ProtiumPower/Pantograph-Robot/python/tests/protocol1_0/My/camera_view.jpg

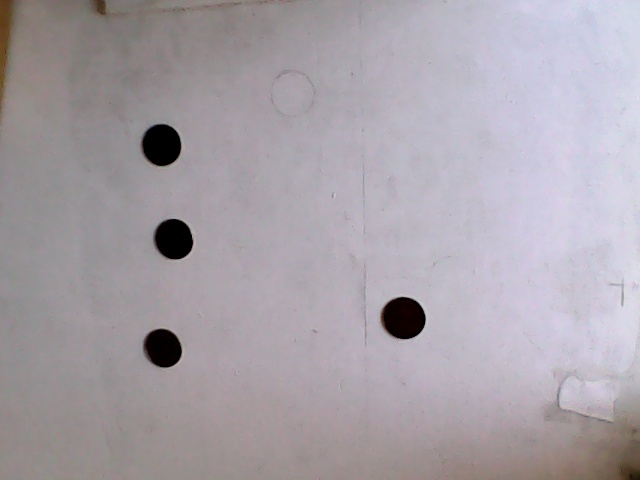
python/tests/protocol1_0/My/camera_view.jpg
