ProtiumPower/Pantograph-Robot/python/tests/protocol1_0/My/rotated.jpg

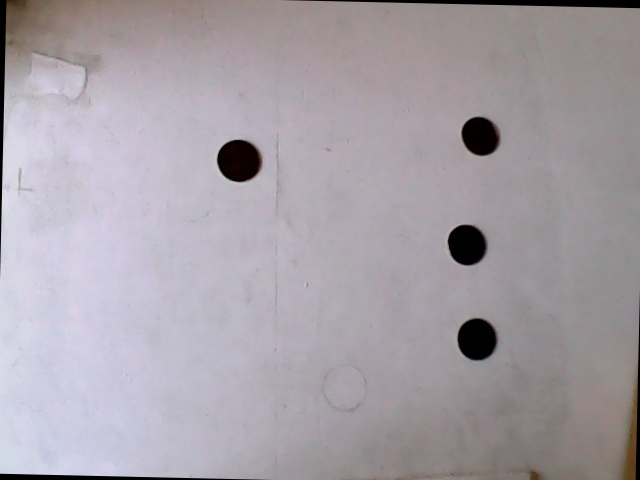
python/tests/protocol1_0/My/rotated.jpg
