ProtiumPower/Pantograph-Robot/Thesis.pdf

# Design and Development of 5 link 2-D Pantograph Parallel Robot

BY

## Ninad Reshim Nakade

(Admission No. 19JE0574)

## Abhishek Aman

(Admission No. 19JE0024)

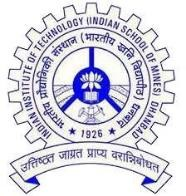
[picture p3: figure]

THESIS SUBMITTED TO

### DEPARTMENT OF MECHANICAL ENGINEERING INDIAN INSTITUTE OF TECHNOLOGY (ISM), DHANBAD – 826004

### 16 May 2023

For the award of the degree of BACHELOR OF TECHNOLOGY

### Supervisor: Prof. Arun Udai

ii

iii

## CERTIFICATE

This is to certify that the thesis titled “Design and Development of 5 link 2-D Pantograph Parallel Robot” being submitted by Mr. Ninad Reshim Nakade (Admission no: 19JE0574) and Mr. Abhishek Aman (Admission no: 19JE0024) for
the award of the degree of Bachelor of Technology in the Department of Mechanical Engineering of Indian Institute of Technology (Indian School of Mines), Dhanbad is a record of bonafide research work carried out by him/her under my supervision. In my opinion, the thesis is worthy of consideration for the award of the degree of Bachelor of Technology in accordance with the regulations of the institute. The results presented in the thesis have not been submitted to any other university or institute for the award of any degree.

Prof. Arun Udai
Assistant Professor
Department of Mechanical Engineering,
Indian Institute of Technology (ISM) Dhanbad-826004, Jharkhand, INDIA

Date: 16-May-2023

iv

## DECLARATION

I hereby declare that the work which is being presented in this dissertation entitled “Design and Development of 5 link 2-D Pantograph Parallel Robot” in partial fulfillment of the requirements for the award of the degree of B.Tech in is an authentic record of my own work carried out during the period from June 2022 to May 2023 under the supervision of Prof. Arun Udai Department of Mechanical Engineering, Indian Institute of Technology (ISM) Dhanbad, Jharkhand, India.
I acknowledge that I have read and understood the UGC (Promotion of Academic Integrity and Prevention of Plagiarism in Higher Educational Institutions) Regulations, 2018. These Regulations were published in the Indian Official Gazette on 31st July, 2018.
I confirm that this Dissertation has been checked for plagiarism using the online plagiarism checking software provided by the Institute. I herewith confirm that the Dissertation has less than 10% similarity according to the plagiarism checking software’s report and meets the MoE/UGC Regulations as well as the Institute’s rules for plagiarism.
I further declare that no portion of the dissertation or its data will be published without the Institute’s or Guide’s permission. I have not previously applied for any other degree or award using the topics and findings described in my dissertation.

Ninad Reshim Nakade
19JE0574

Mr. Abhishek Aman
19JE0024

vi

vii

## ACKNOWLEDGEMENTS

We would like to convey our appreciation to all whom have played a role for completion of his/her B. Tech thesis work. We would like to thank our supervisor Prof Arun Udai who has provided us with crucial components of the work like motors, SBC, carbon fibre rods, helpful guidance among many other useful things. We would like to thank head of the department Prof Amit Dixit for granting us permission for 3D printing all the necessary components. We would like to thank 3D printing lab in-charge Mr.Gopalji for assisting us and helping us to 3D print all necessary components. We would also like to thank Robotics and Automation Lab research scholars Mr. Himanshu Varshney and Mr. Ashish Sidharth for helping us in our work.

Ninad Reshim Nakade
Abhishek Aman

Date:16-May-2023

viii

ix

## ABSTRACT

The paper describes the process of Design and Development of 5 link 2-D Pantograph Parallel Robot for vision-based pick and place operations. Mechanical design, manufacturing of components and development of the control software, consisting of image segmentation using HSV thresholding to extract the object coordinates and implement the Inverse kinematics to get the actuator
output | angles | have | been | discussed.

x

xi

# Contents

1 Introduction | 1
2 Review of Literature | 2
3 Methodology for Designing | 5
4 Kinematics and Control Procedure | 14
4.2 Image Processing using Hue Saturation Value | 19.

### 5 Conclusions and Future Work

5.1 Result and Conclusion | 22

xi

5.2 Future Work | 23
Appendix | 24
Bibliography | 24

# List of Figures

1.1 CAD Design of 2-DOF, Pantograph Robot | 1
2.1 The planar 5R parallel mechanism | 2
2.2 Line Diagram of Link Lengths | 3
2.3 Theoretical workspace | 3
2.4 Design Space of 5R Mechanism | 4
2.5 Workspace with Singularity in +- | 4
3.1 Model of Pantograph Robot in Solid works | 5
3.2 Coupler | 6
3.3 Lower Joint | 7
3.4 Upper Joint | 8
3.5 Upper End Joint | 9
3.6 Lower End Joint | 10
3.7 Link 1 and Link 4 | 11
3.8 Link 2 and Link 3 | 12
3.9 Assembly | 13
3.10 Oscillating motion between limits of workspace with 1 Hz frequency 13 3.11 Oscillating motion between limits of workspace with 1 Hz frequency
and 90° phase difference | 14
4.1 The planar 5R parallel mechanism | 15
4.2 Solutions of inverse kinematics | 17
4.3 Solutions of Forward kinematics | 17
4.4 Diagram of Pantograph with Coordinate system | 18
4.5 Rotated Image | 19
4.6 Conversion to hsv | 19
4.7 Applying hsv thresholding | 19

4.8 Pixel Coordinates of Centers | 19
4.9 Image from USB Webcam | 19
4.10 Pixel to Cartesian Transformation | 20
4.11 Workflow | 21
4.12 Executing Program | 21
5.1 Single Acting Pneumatic Actuator | 23

# Chapter 1

# Introduction

The Pantograph is a kind of mechanism or more specifically a linkage which has only lower joints, consists of 5 links and 5 revolute joints. It is a planer 2D linkage. From Kutzbach criterion, it can be seen that it has 2 degrees of freedom, which means that the mechanism can defined by 2 parameters. The 2 parameters are the angles of 2 links attached to 2 motors which are fixed on frame. The next two links are connected together at a point, forming a closed chain, parallel robot. This is the end point that are we trying to control to traverse the 2D plane to pick
and place magnetic objects with help of a linear actuator and an electromagnet working as end effector. The position input will be provided by a camera which will locate the object to be picked and placed.

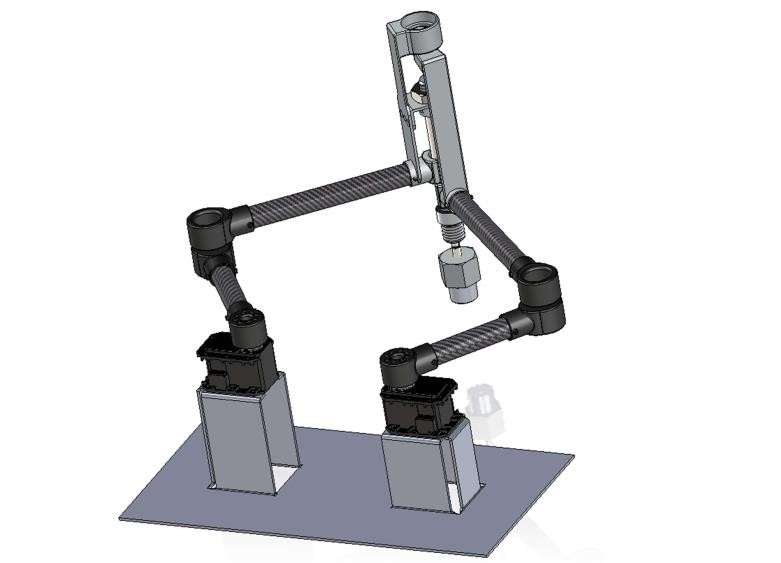
[picture p4: figure]

Figure 1.1: CAD Design of 2-DOF, Pantograph Robot.

# Chapter 2

# Review of Literature

## 2.1 Determination of Link Lengths and Dimensions

The choice of link length is one of the core features of this study. [1] and [2] papers are in continuation where first paper discusses identification of range of link length ratios and singularities associated with it. Paper [2] discusses various performance indexes through performance atlases in design space associated with link lengths for optimal link length.

### 2.1.1 Kinematics

For kinematics, refer to section 4.1.

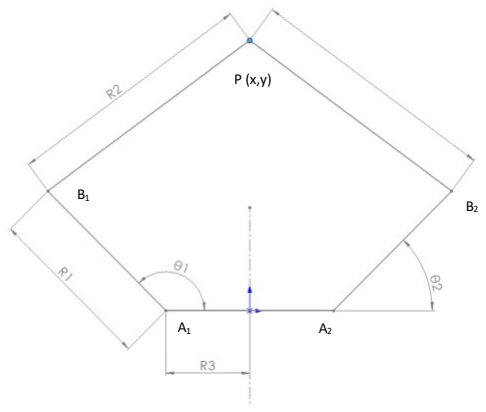
[picture p5: figure]

(a) Pantograph | (b) Coordinate System

Figure 2.1: The planar 5R parallel mechanism.

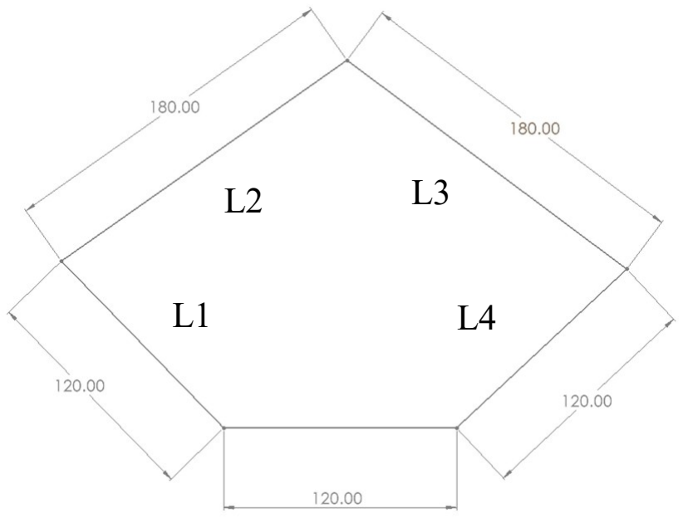
[picture p6: figure]

Figure 2.2: Line Diagram of Link Lengths

### 2.1.2 Theoretical workspace

Theoretical workspace is the area bound where the end effector can reach.

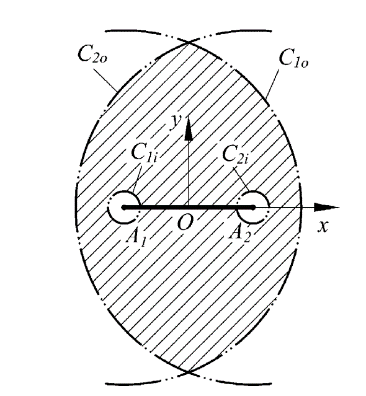
[picture p7: figure]

Figure 2.3: Theoretical workspace

Curve C2o is formed when link L1 and L2 are parallel hence fully extended. Similarly curve C1o is formed by L3 and L4.

Curve C2i is formed when link L1 and L2 are anti-parallel hence fully retracted. Similarly curve C1i is formed by L3 and L4.

### 2.1.3 Jacobian Matrix

The Jacobian Matrix relates joint angle velocities to end effector velocity.

From section 4.1, equations 6) and 7) can be differentiated to with respect to time to obtain velocity equations.

A dθ/dt =B dv/dt

Jacobian Matrix of mechanism can then be written as

J=A⁻¹ B

### 2.1.4 Singularites

Singularities are conditions when

1. Workspace Boundary is reached.
2. Jacobian becomes singular. In that case the DOF mechanism changes instantaneously. It can arise when either A or B or both becomes singular.

The paper further discusses study of link length ratios and maps of theoretical workspace along with associated singularities.

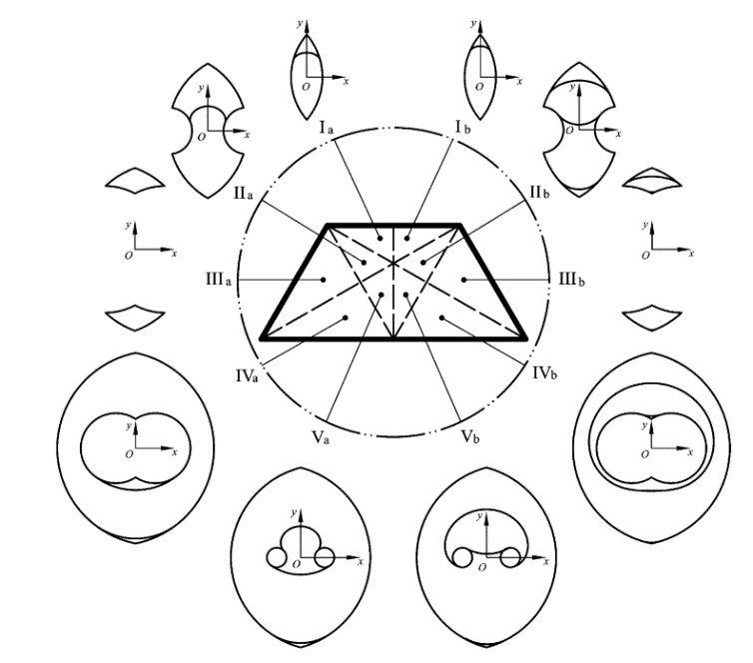
[picture p8: figure]
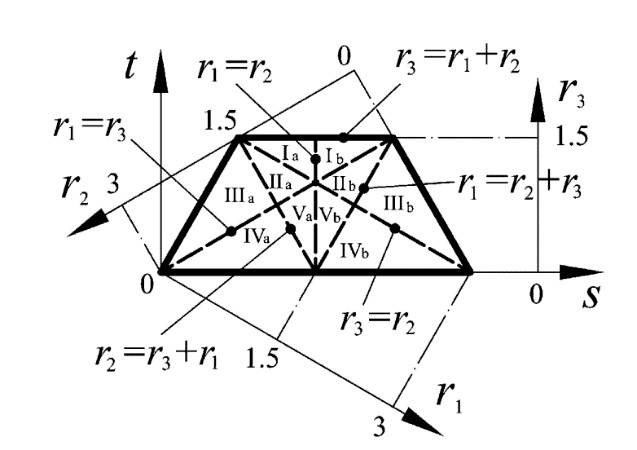
[picture p9: figure]

Fig 2.4: Design Space of 5R Mechnaism | Fig 2.5: Workspace with Singularity in +-

Work Area can be doubled condition r2=r3+r1.
From figure 2.4, it can be seen that region IVa and Va divided by r2=r3+r1 has sufficient workspace free from singularity. We tried to stay on line r2=r3+r1.

# Chapter 3

# Methodology for Designing

## 3.1 Design and Manufacturing of Components

The Pantograph Robot is designed in the Solidworks 2022 program and has two degrees of freedom. The goal of design is to cover an area on plane as discussed in the literature which is taken as 450mmx350mm.

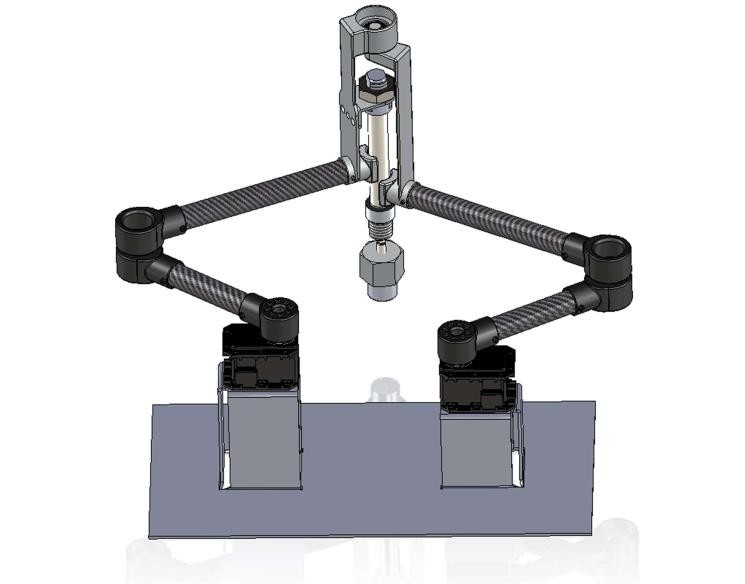
[picture p10: figure]

Figure 3.1: Model of Pantograph Robot in Solidworks

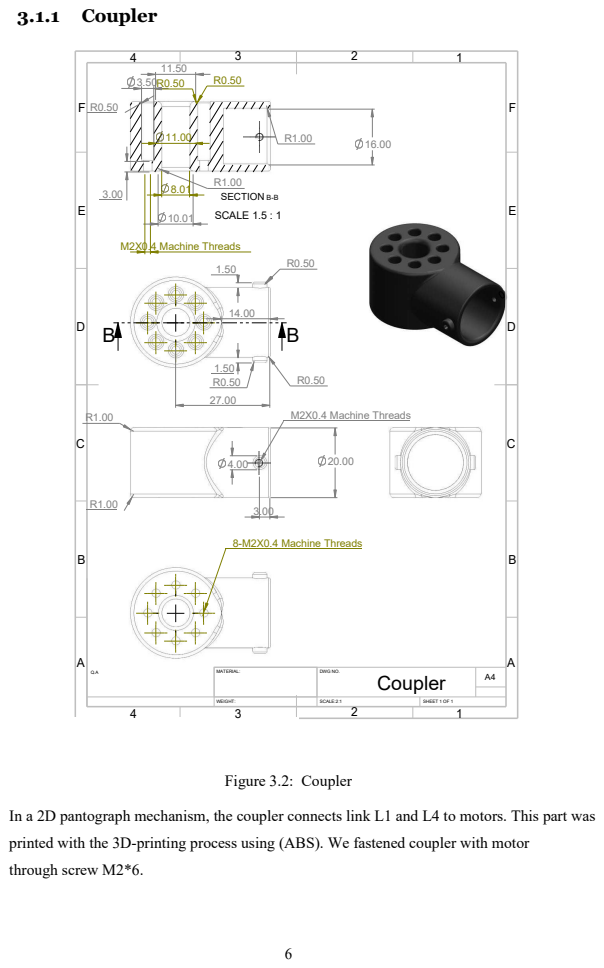
[picture p11: page 20]
R1.00 SECTION B-B; SCALE 1.5 : 1; M2X0.4 Machine Threads; 8-M2X0.4 Machine Threads; 3.1.1 Coupler; Figure 3.2: Coupler

MATERIAL: | DWG NO. | A4 Coupler

WEIGHT: | | SCALE:2:1 | SHEET 1 OF 1

In a 2D pantograph mechanism, the coupler connects link L1 and L4 to motors. This part was
printed with the 3D-printing process using (ABS). We fastened coupler with motor
through screw M2*6.

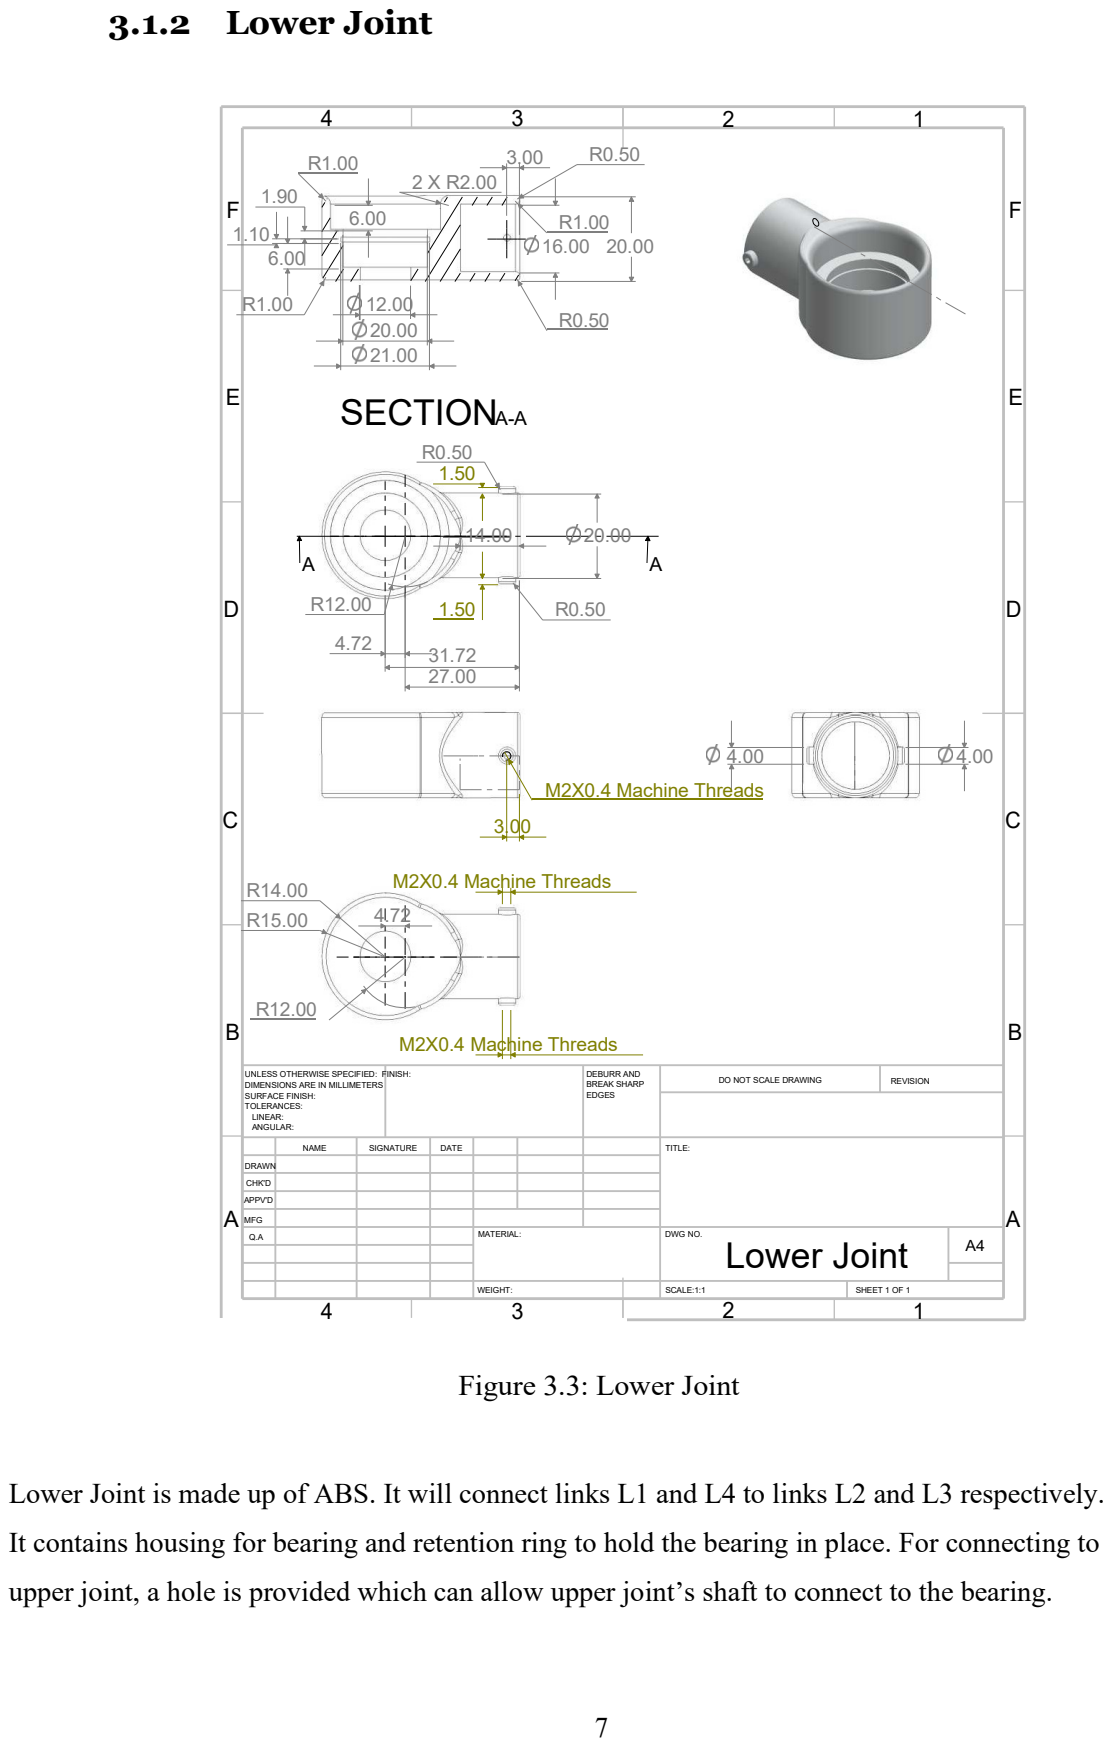
[picture p12: page 21]
12.00 20.00 21.00 SECTIONA-A; M2X0.4 Machine Threads; DEBURR AND BREAK SHARP EDGES; DO NOT SCALE DRAWING; REVISION; A MFG; MATERIAL:; DWG NO.; Lower Joint; 3.1.2 Lower Joint

UNLESS OTHERWISE SPECIFIED: FINISH:
DIMENSIONS ARE IN MILLIMETERS
SURFACE FINISH:
TOLERANCES:
LINEAR:
ANGULAR:

NAME | SIGNATURE | DATE | TITLE:

DRAWN
CHK'D
APPV'D

WEIGHT: | SCALE:1:1 | SHEET 1 OF 1

Figure 3.3: Lower Joint

Lower Joint is made up of ABS. It will connect links L1 and L4 to links L2 and L3 respectively.
It contains housing for bearing and retention ring to hold the bearing in place. For connecting to
upper joint, a hole is provided which can allow upper joint’s shaft to connect to the bearing.

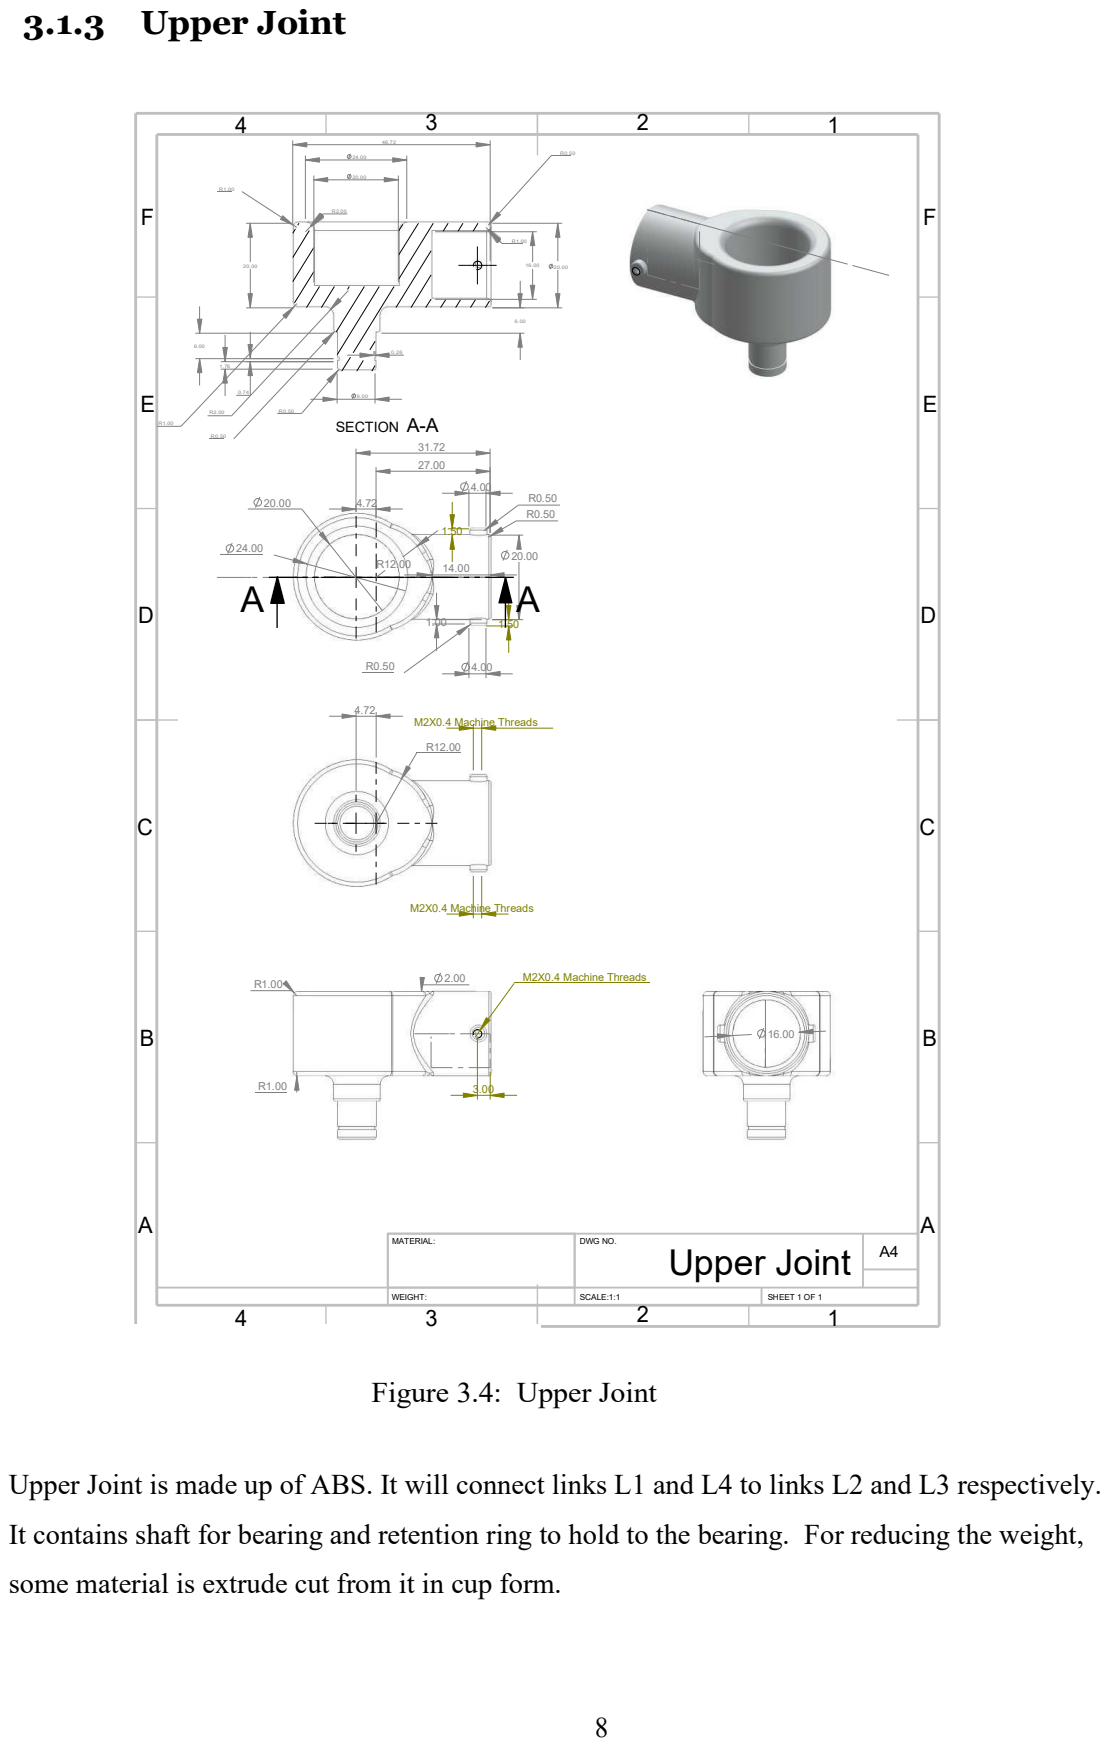
[picture p13: page 22]
SECTION A-A; M2X0.4 Machine Threads; 3.1.3 Upper Joint

MATERIAL: | DWG NO. | A4 Upper Joint

WEIGHT: | | SCALE:1:1 | SHEET 1 OF 1

Figure 3.4: Upper Joint

Upper Joint is made up of ABS. It will connect links L1 and L4 to links L2 and L3 respectively.
It contains shaft for bearing and retention ring to hold to the bearing. For reducing the weight,
some material is extrude cut from it in cup form.

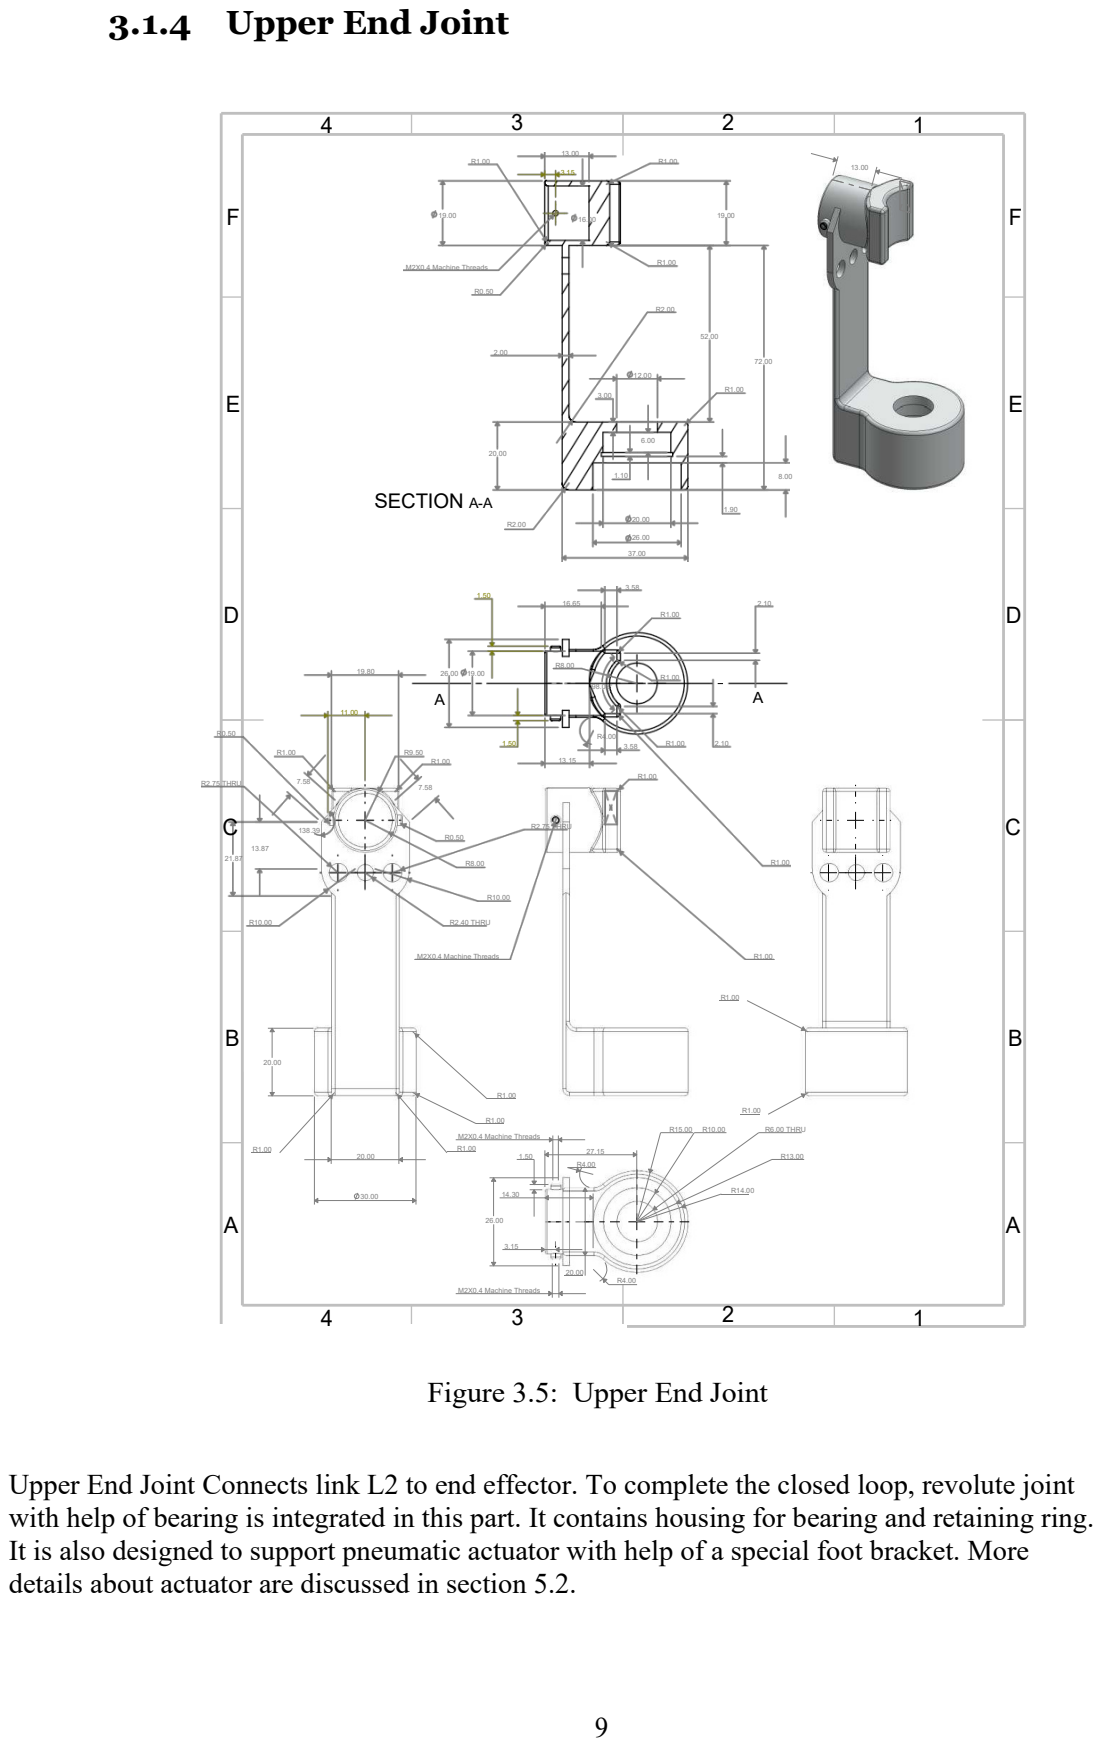
[picture p14: page 23]
M2X0.4 Machine Threads; SECTION A-A; R2.75 THRU; R2.40 THRU; M2X0.4 Machine Threads R1.00; R6.00 THRU

3.1.4 Upper End Joint

D R 0.50 THRU C 21.87 | D C

Figure 3.5: Upper End Joint

Upper End Joint Connects link L2 to end effector. To complete the closed loop, revolute joint
with help of bearing is integrated in this part. It contains housing for bearing and retaining ring.
It is also designed to support pneumatic actuator with help of a special foot bracket. More
details about actuator are discussed in section 5.2.

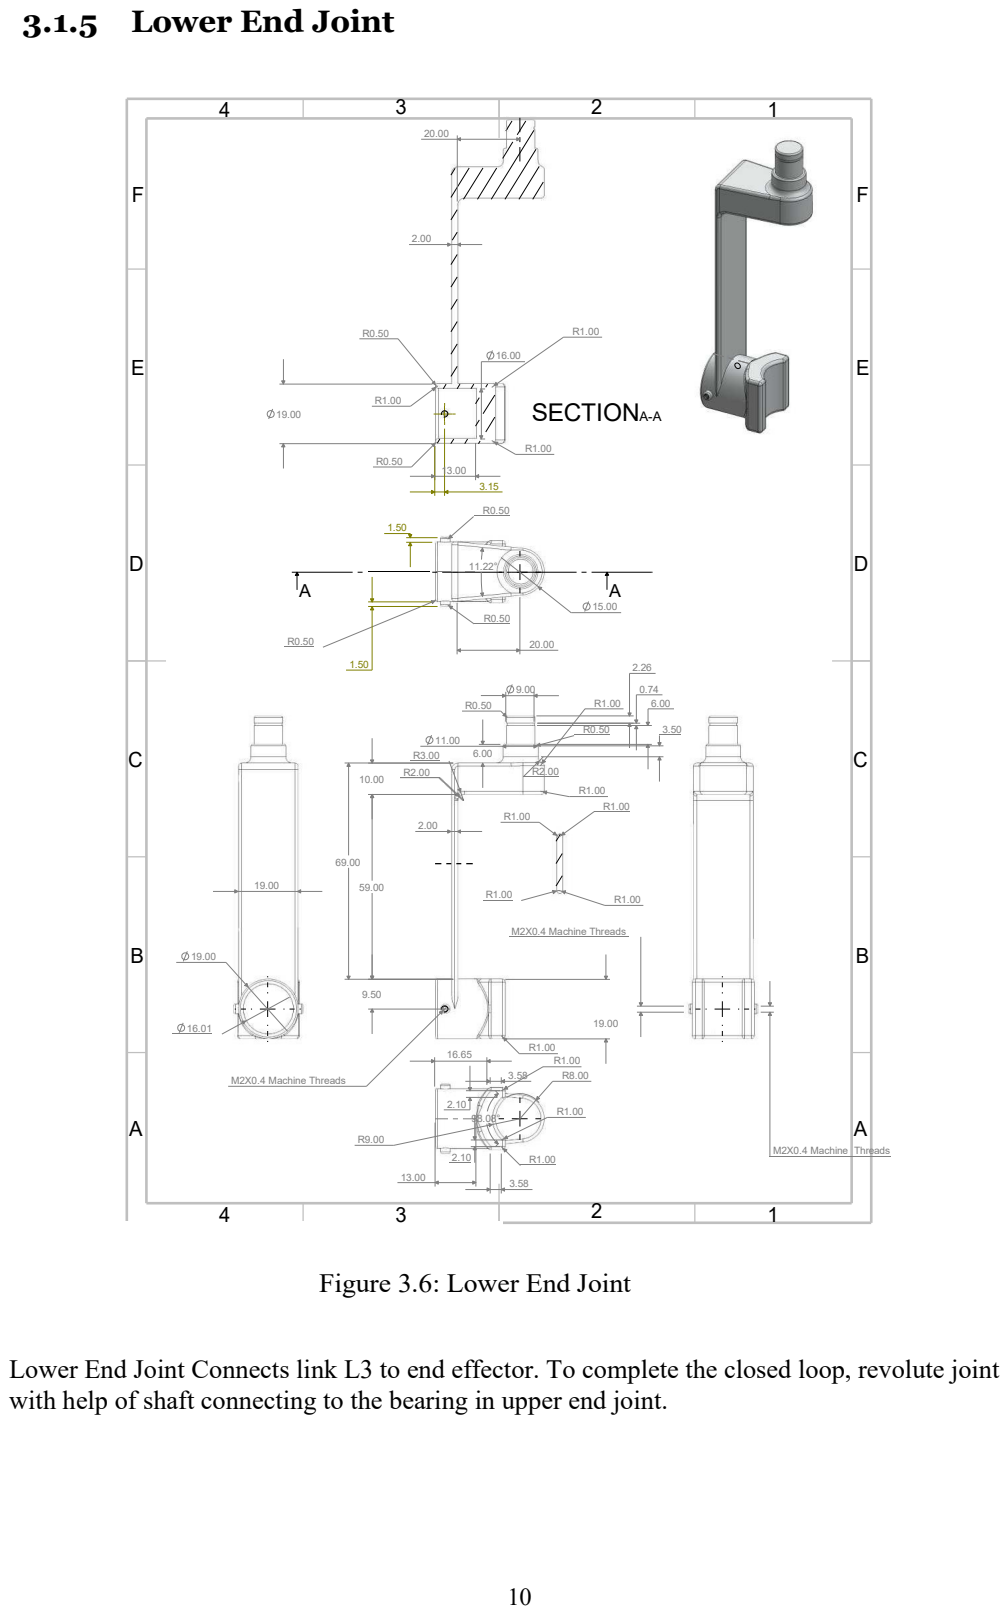
[picture p15: page 24]
SECTIONA-A; M2X0.4 Machine Threads; M2X0.4 Machine; eads; Thr

3.1.5 Lower End Joint

Figure 3.6: Lower End Joint

Lower End Joint Connects link L3 to end effector. To complete the closed loop, revolute joint
with help of shaft connecting to the bearing in upper end joint.

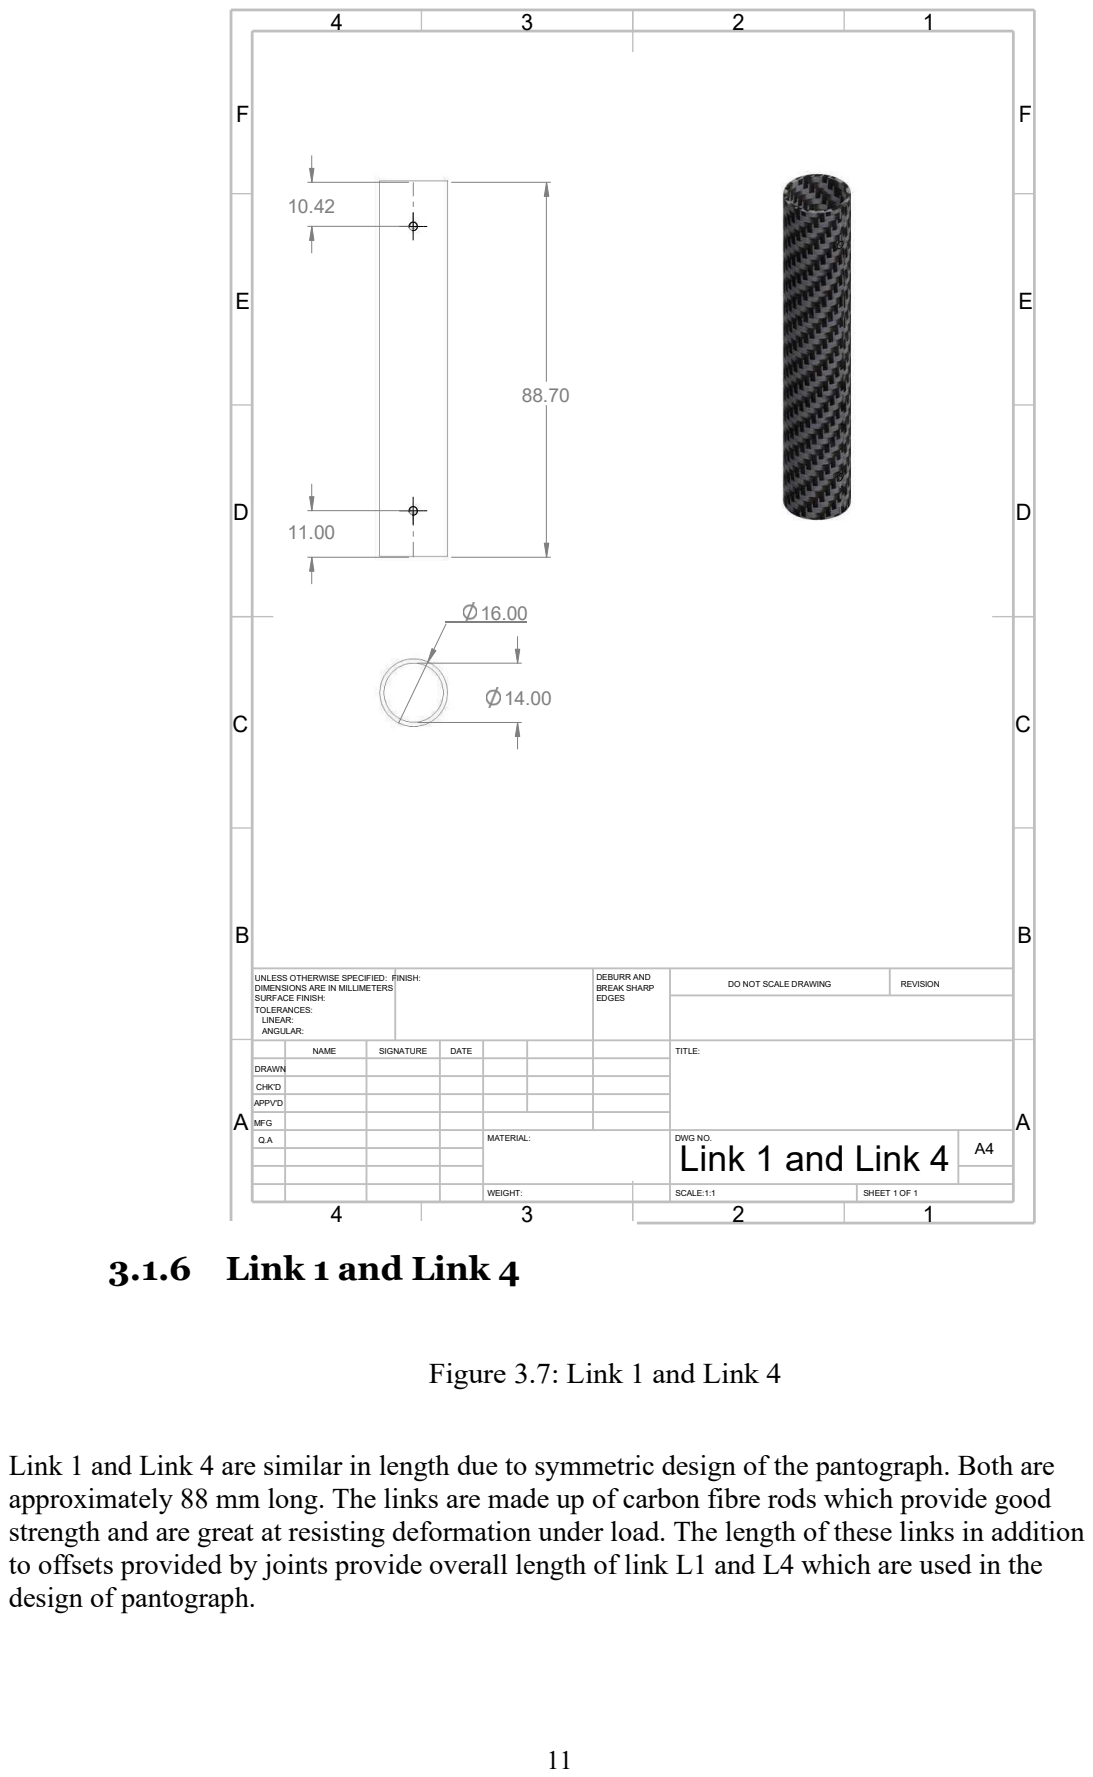
[picture p16: page 25]
DEBURR AND BREAK SHARP EDGES; DO NOT SCALE DRAWING; REVISION; A MFG; MATERIAL:; DWG NO.; WEIGHT: 3; SCALE:1:1; SHEET 1 OF 1

UNLESS OTHERWISE SPECIFIED: FINISH:
DIMENSIONS ARE IN MILLIMETERS
SURFACE FINISH:
TOLERANCES:
LINEAR:
ANGULAR:

NAME | SIGNATURE | DATE | TITLE:

DRAWN
CHK'D
APPV'D

Link 1 and Link 4

3.1.6 Link 1 and Link 4

Figure 3.7: Link 1 and Link 4

Link 1 and Link 4 are similar in length due to symmetric design of the pantograph. Both are
approximately 88 mm long. The links are made up of carbon fibre rods which provide good
strength and are great at resisting deformation under load. The length of these links in addition
to offsets provided by joints provide overall length of link L1 and L4 which are used in the
design of pantograph.

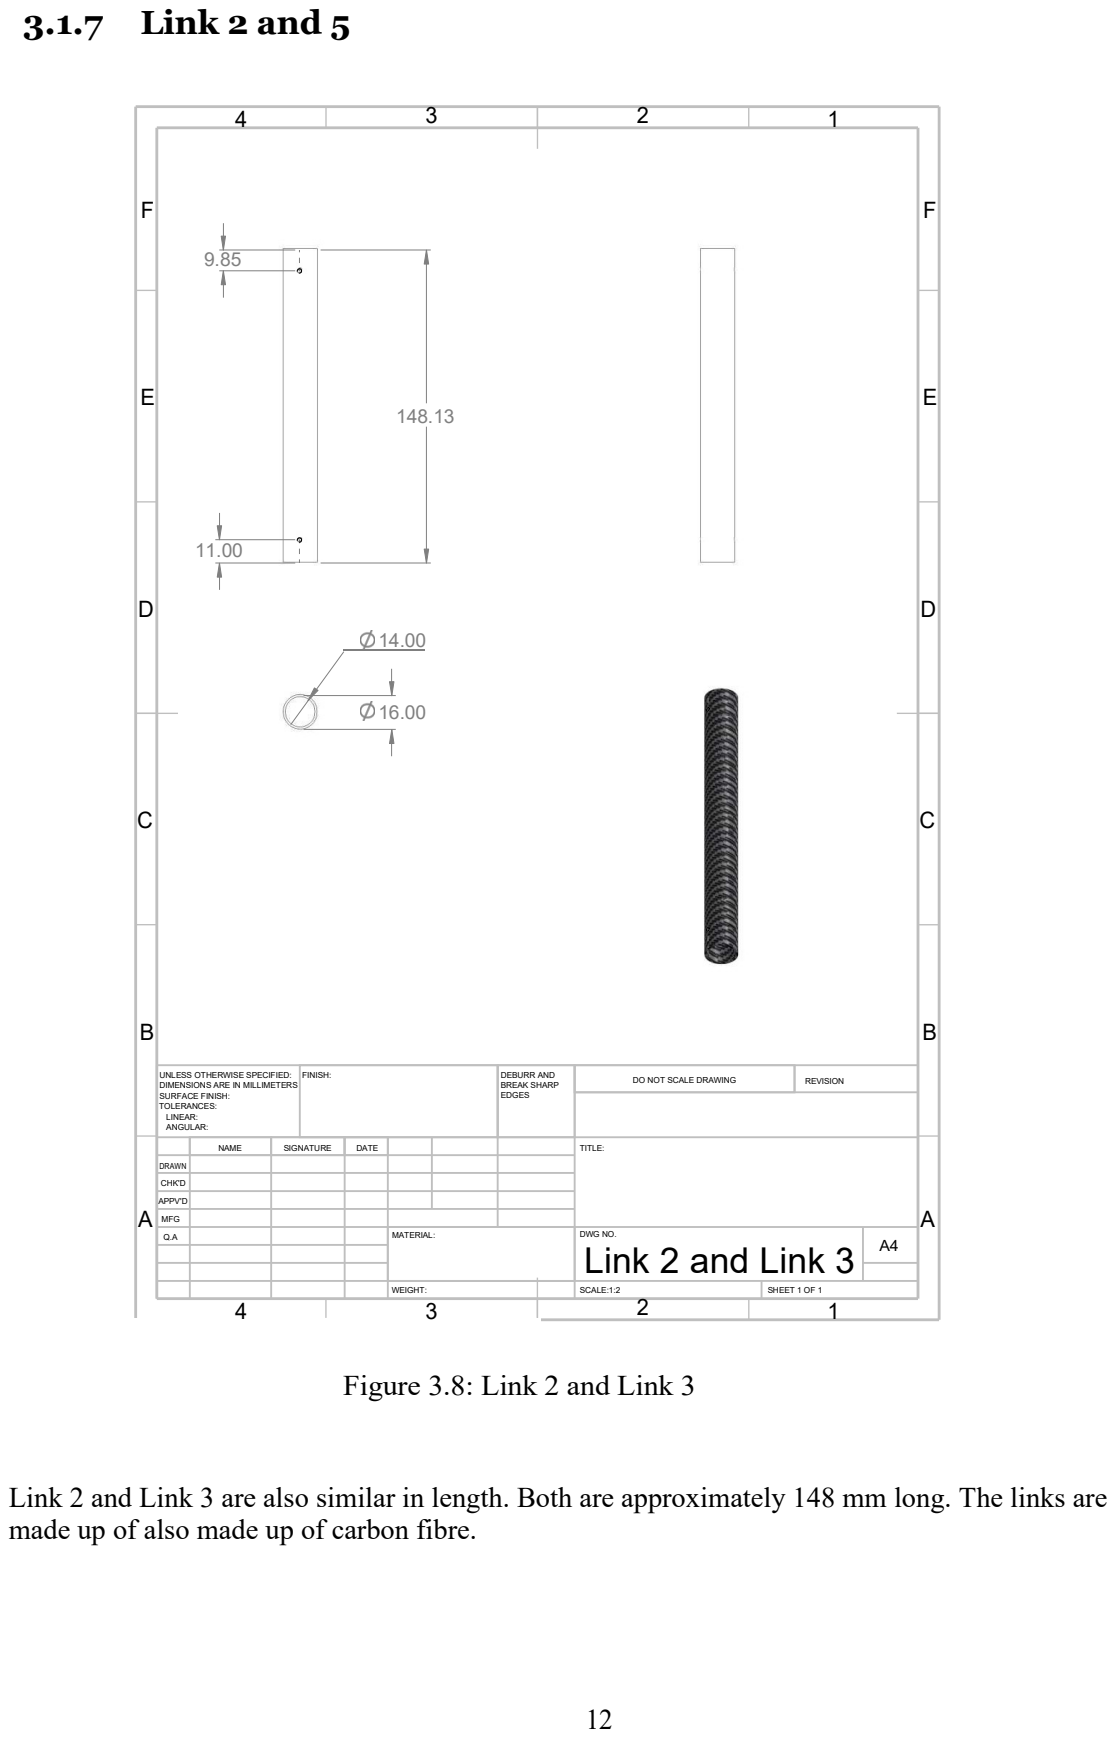
[picture p17: page 26]
WEIGHT:; SCALE:1:2; SHEET 1 OF 1; DO NOT SCALE DRAWING; REVISION; DEBURR AND BREAK SHARP EDGES; 3.1.7 Link 2 and 5

UNLESS OTHERWISE SPECIFIED: FINISH:
DIMENSIONS ARE IN MILLIMETERS
SURFACE FINISH:
TOLERANCES:
LINEAR:
ANGULAR:

NAME | SIGNATURE | DATE | | | TITLE:

DRAWN
CHK'D
APPV'D
Q.A | | | | MATERIAL: | DWG NO. | A4 Link 2 and Link 3

MFG

Figure 3.8: Link 2 and Link 3

Link 2 and Link 3 are also similar in length. Both are approximately 148 mm long. The links are
made up of also made up of carbon fibre.

## 3.2 Assembly

All the components were bought or manufactured; assembly of the structure was performed. For the base platform, 6 mm thick plywood was used which gives freedom to modify it more easily than metal frame for attaching other components. For providing motion, we are using Dynamixel MX-28 motors. The motors have sufficiently high torque. The simulations of simple oscillating motion show that the maximum torque (170 Nmm) occurring in motion is fulfilled by the motor.

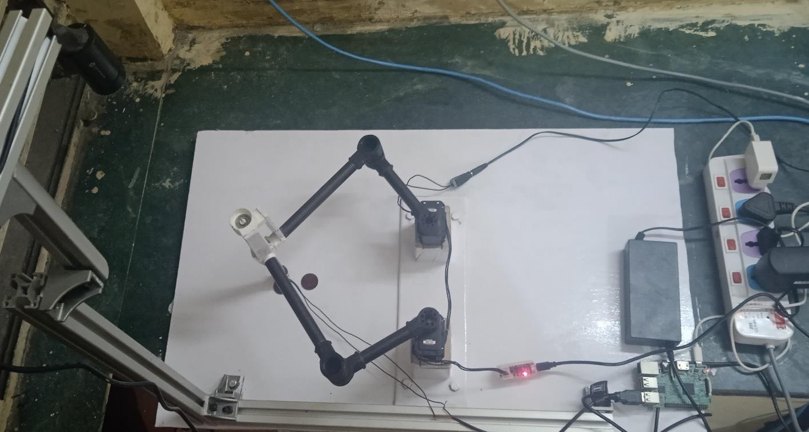
[picture p18: figure]

Figure 3.9 Assembly

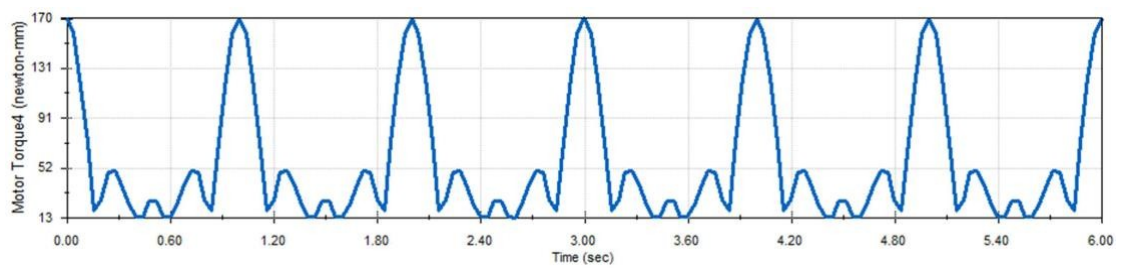
[picture p19: figure]

Figure 3.10: Oscillating motion between limits of workspace with 1 Hz frequency

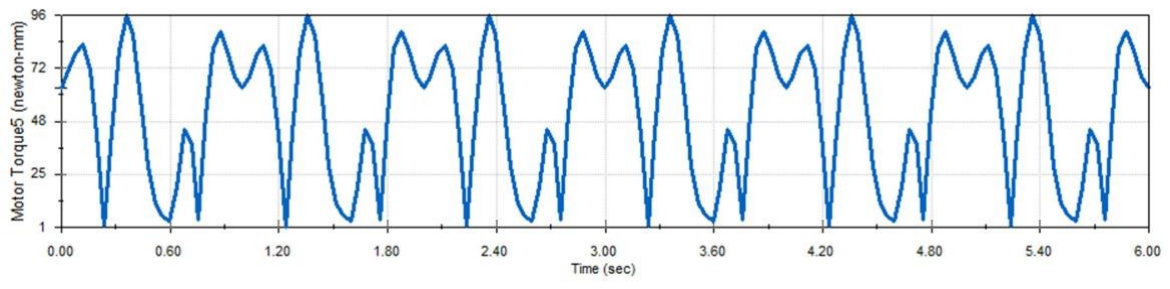
[picture p20: figure]

Figure 3.11: Oscillating motion between limits of workspace with 1 Hz frequency and 90° phase difference

# Chapter 4

# Kinematics and Control Procedure

To interact with hardware to perform the required task of moving to the location
of the object, control is necessary. Kinematics is required to establish relation between Cartesian Coordinates of end effector and rotation angles of the motors.

## 4.1 Inverse Kinematics

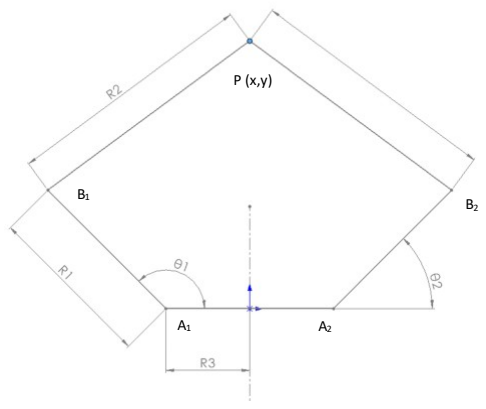
[picture p21: figure]
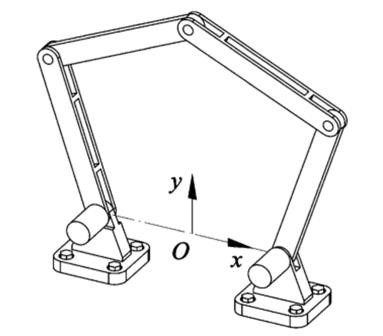
[picture p22: figure]

(a) Pantograph | (b) Coordinate System

Figure 4.1: The planar 5R parallel mechanism.

Position of point P that is end effector is given by vector p is given as

p= (x, y) T
3)

Positions of points B1 and B2 are given as

B1 = (r1 cosθ1 -r1sinθ2)

T

and

B2 = (r1 cosθ1 -r1sinθ2)

T | 4)

Distance between P and B is given by.

|PBi|=r2 | i=1 and 2 | 5)

In another form it can be written as

(x-r1cosθ1+r3)

| 2 + (y-r1sinθ1)

2= r2

2
| | 6)

(x-r1cosθ1+r3)

| 2 + (y-r1sinθ1)

2= r2

2
| | 7)

Input position can be obtained as

θi=2tan⁻¹(zi) | i=1,2 | 8)

here

zi =

# −bi+ki √bi 2−4aici

2
2ai
9)

where

ki= 1 or -1
a1=r1

2 + y² +(x+r3)

2
-r2

2
-2(x+r3) r1

b1=-4yr1

c1=r1

2 + y² +(x+r3)

2
-r2

2
-2 (x+r3) r1

a2=r1

2 + y² +(x-r3)

2
-r2

2
-2 (x-r3) r1

b2=-4yr1

c2=r1

2 + y² +(x-r3)

2
- r2

2
-2(x-r3) r1

There are solutions we will use for this, we by putting ki= 1 or -1 and i=1 or 2 for a, b, c. The solutions are denoted as “++”, “+-”, “-+” and “--”. Out of these, we will be sticking to “+-mode.

a. +- | b. - + | c. + + | d. - -

Figure 4.2: Solutions of inverse kinematics.

In addition to inverse kinematics, forward kinematics also have 2 solutions- up configuration and down configuration. Paper [1] is based on up and “+-” configuration. We are following it as well.

a. Up | b. Down

Figure 4.3: Solutions of Forward kinematics

Due to physical limitations of the joints of end effector, the angle between the links (α) should be greater than 55°. Vector dot product of the vector of two links can be used to calculate
the angle.

# cos−1

(PB1

)∗(B2P)
|PB1

||B2P|

= α | 10)

As PB1 and PB2 have magnitude equal to r2, we can write

# cos−1

(PB1

)∗(B2P)
r2
2 = α | 11)

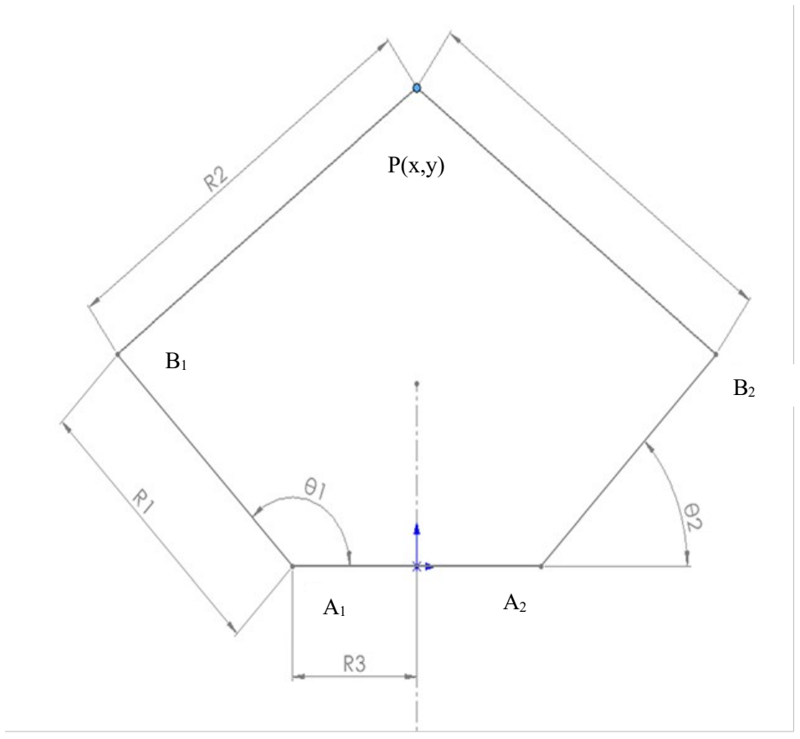
[picture p23: figure]

## Figure 4.4: Diagram of Pantograph with Coordinate system

## 4.2 Image Processing using Hue Saturation Value

A USB webcam was mounted on the frame of the robot. The coordinate of centroid of the image is determined. HSV thresholding or binary masking was used to extract the object from the background. HSV separates colour information from intensity or lighting. As value is separated, rules for thresholding can be easily framed using only hue and saturation

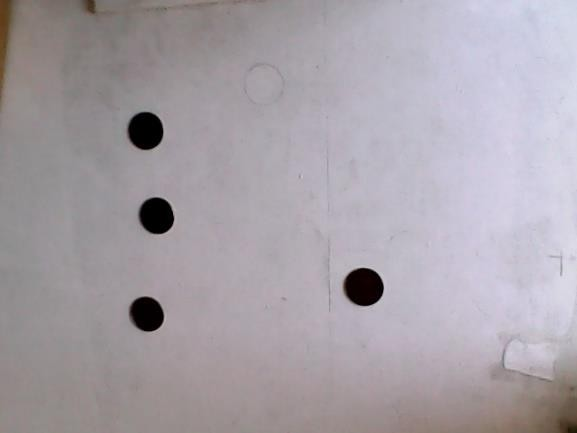
[picture p24: figure]
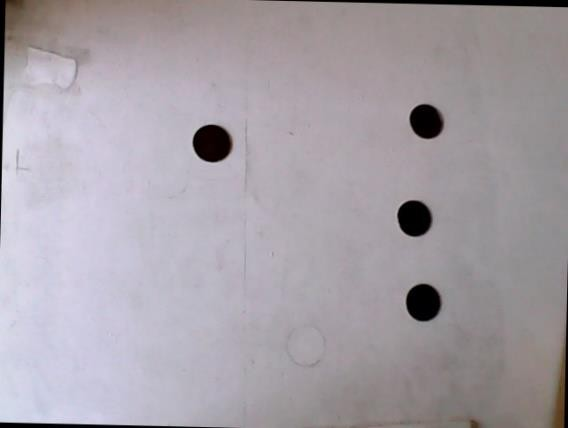
[picture p25: figure]

Figure 4.5: Image from USB Webcam | Figure 4.6: Rotated Image

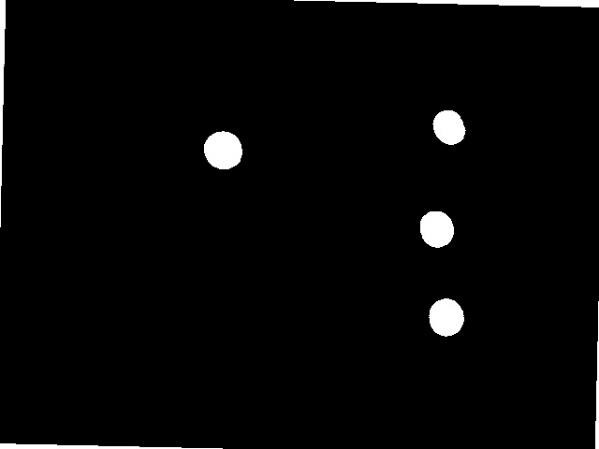
[picture p26: figure]
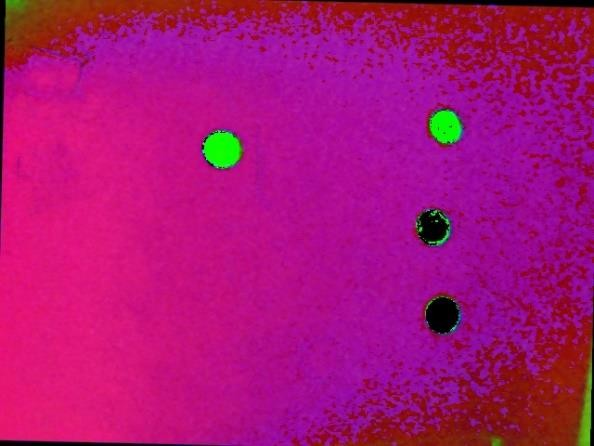
[picture p27: figure]

Figure 4.7: Conversion to hsv | Figure 4.8: Applying hsv thresholding

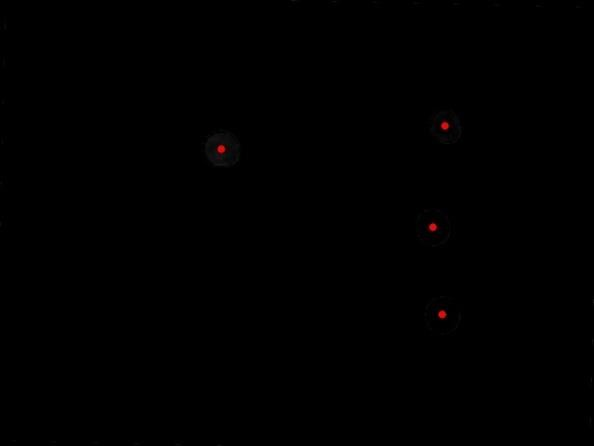
[picture p28: figure]

Figure 4.9: Pixel Coordinates of Centers

## 4.3 Pixel to Cartesian Coordinates

The pixel center of the object obtained from hsv algorithm is then transformed into Cartesian coordinates with respect to base frame. For this purpose, the pixel to image scale, rotation and offsets is calculated from experimentation. The image is rotated, scaled and offsets are ad8ded to get Cartesian coordinates

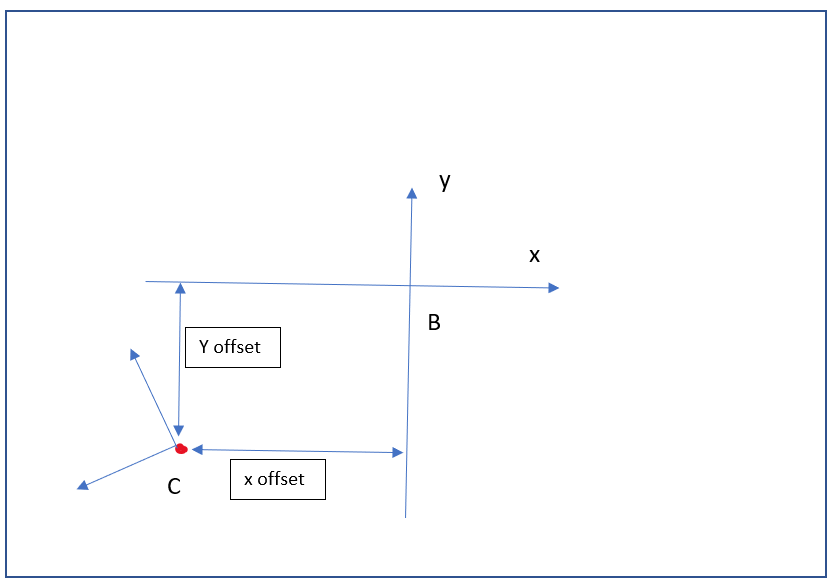
[picture p29: figure]

Figure 4.10: Pixel to Cartesian Transformation B: Fixed Base Cartesian Frame C: Camera pixel frame

## 4.4 Flow Chart of Function Calls

Figure 4.11: WorkFlow

The function prints pixel coordinates of points detected then prints converted cartesian coordinates, then gives motor angles for valid points and then passes the angles to the motors.

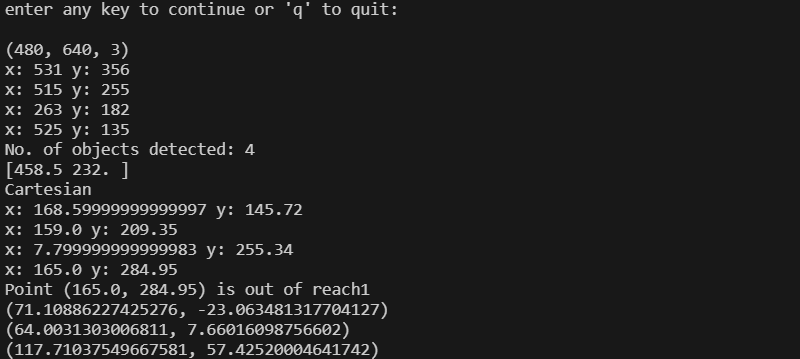
[picture p30: figure]

Figure 4.12: Executing Program

# Chapter 5

# Results and Future Work 5.1 Results and Conclusion

The paper presents the design and development of Pantograph robot. The chosen link lengths and motor specifications are based on the required workspace and the required degree of resolution of the end-effector. The components of this structure were designed in Solidworks 2022, after which they were manufactured using 3D printing technology. In 3D printing FDM (Fused Deposition Method) based printers were used.
After manufacturing and purchasing the components, the robot has been assembled and integrated with a python code to identify coloured objects in its workspace and pick from its home position to the target location. The pick and place task of objects ha been successfully performed.

# 5.2 Future Work

For picking magnetic objects, the single acting pneumatic actuator is proposed to be attached to the end effector of the pantograph robot, which will help in picking objects lying down with help of electromagnet. The single acting model proposed is from Janatics. The actuator has stroke of 5 cm.

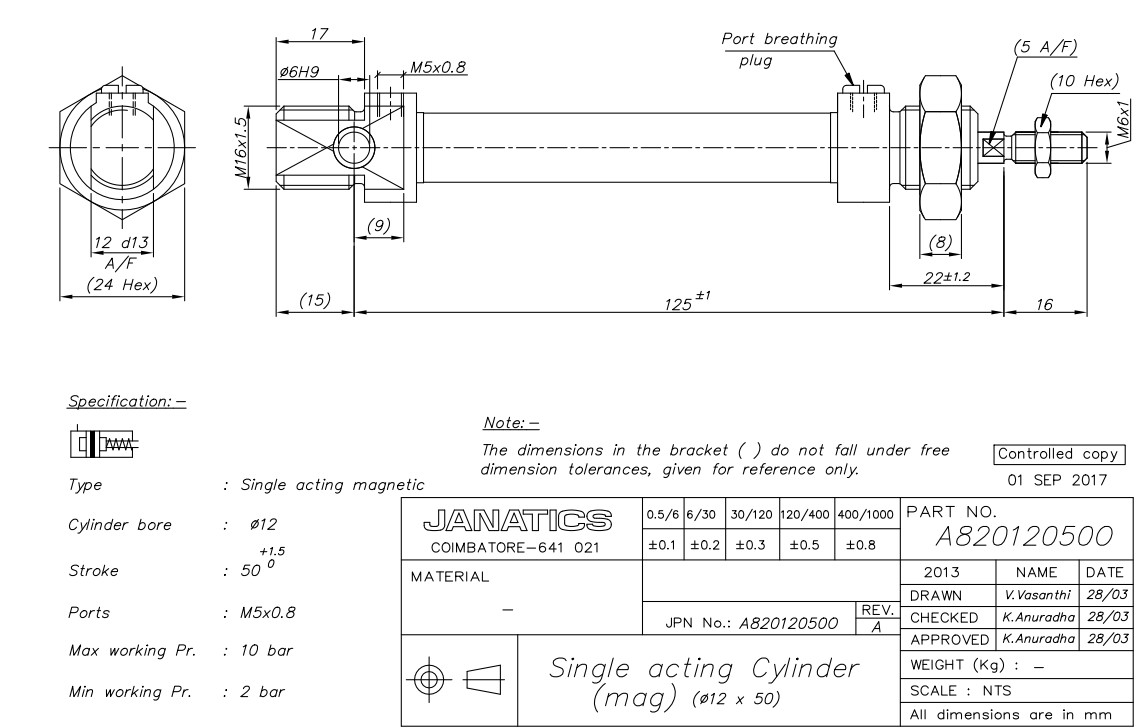
[picture p31: figure]

Figure 5.1: Single Acting Pneumatic Actuator

# Appendix A

## A.1 Python Code for Pick and Place Operation

To get the python code visit: https://github.com/ProtiumPower/Pantograph-Robot/blob/main/python/tests/protocol1_0/My/M.py

## A.2 CAD Model

Cad model is available here: https://github.com/ProtiumPower/Pantograph-Robot/tree/main/Assembly

# Bibliography

[1] Kinematics, singularity and workspace of planar 5R symmetrical parallel mechanisms http://dx.doi.org/10.1016/j.mechmachtheory.2005.05.004
[2] Performance atlases and optimum design of planar 5R symmetrical parallel mechanisms http://dx.doi.org/10.1016/j.mechmachtheory.2005.05.003
[3] Guidance for Pantograph Development Methodology https://www.redalyc.org/jatsRepo/614/61465285005/
[4] [Robotis, 2022] Robotis (2022)
