ProtiumPower/Pantograph-Robot/Assembly/SKF_W_619_9_2Z/SKF_W_619_9_2Z.sldasm

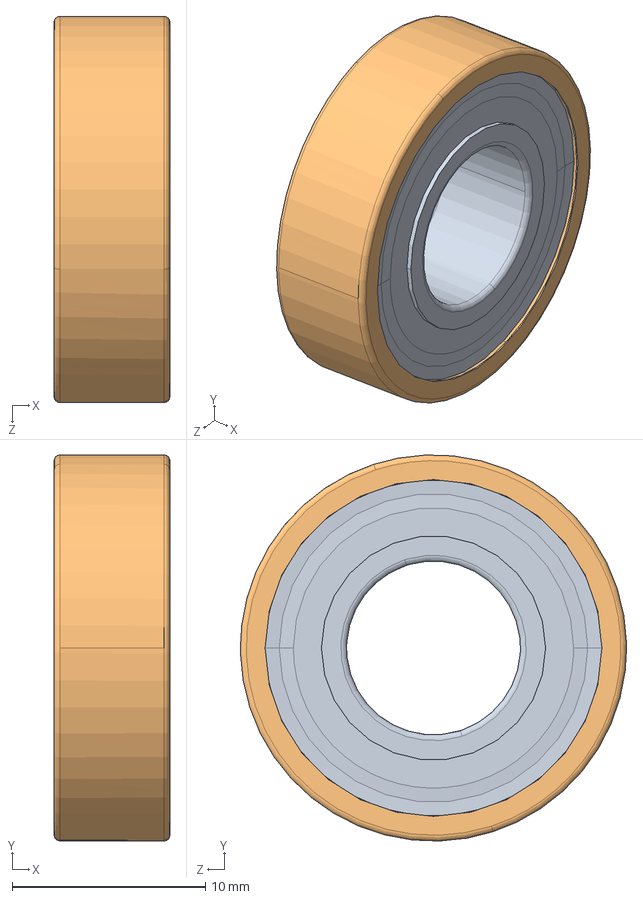
[picture p32: CAD file, 2023-05-20]
Assembly/SKF_W_619_9_2Z/SKF_W_619_9_2Z.sldasm
6.00 x 20.0 x 20.0 mm
SKF_W_619_9_2Z_12 x 8
SKF_W_619_9_2Z_21
SKF_W_619_9_2Z_23
