ProtiumPower/Pantograph-Robot/Assembly/60 Janatics-A51,A52 Series/Janatics-A51, A52 Series.SLDASM

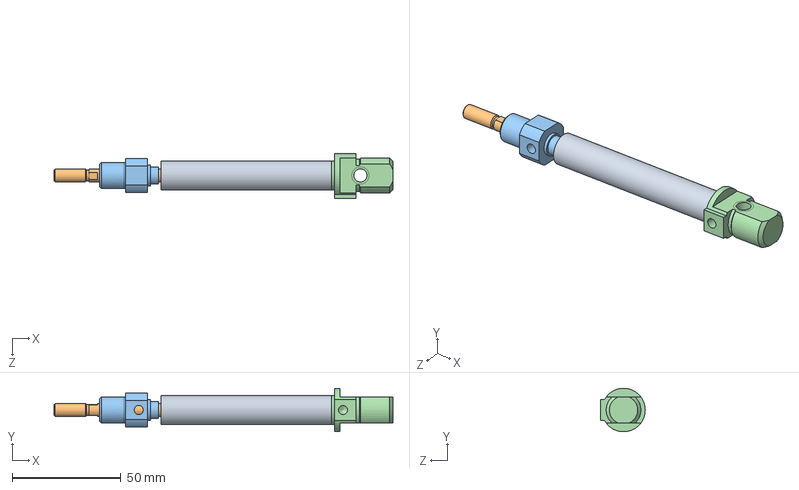
[picture p33: CAD file, 2023-05-20]
Assembly/60 Janatics-A51,A52 Series/Janatics-A51, A52 Series.SLDASM
156.0 x 20.0 x 20.5 mm
Janatics-A51, A52 Series_REC-1(new)
Janatics-A51, A52 Series_FEC(new)
Janatics-A51, A52 Series_piston rod (10C)(new)
Janatics-A51, A52 Series_cylinder barral (10A)(new)
