ProtiumPower/Pantograph-Robot/Assembly/60 Janatics-A51,A52 Series/Janatics-A51, A52 Series_piston rod (10C)(new).SLDPRT

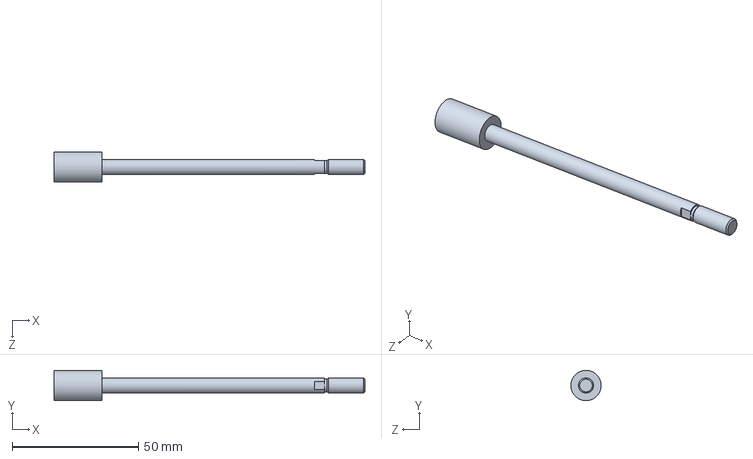
[picture p34: CAD file, 2023-05-20]
Assembly/60 Janatics-A51,A52 Series/Janatics-A51, A52 Series_piston rod (10C)(new).SLDPRT
123.0 x 12.0 x 12.0 mm
