ProtiumPower/Pantograph-Robot/Assembly/SKF_W_619_9_2Z/SKF_W_619_9_2Z_12.sldprt

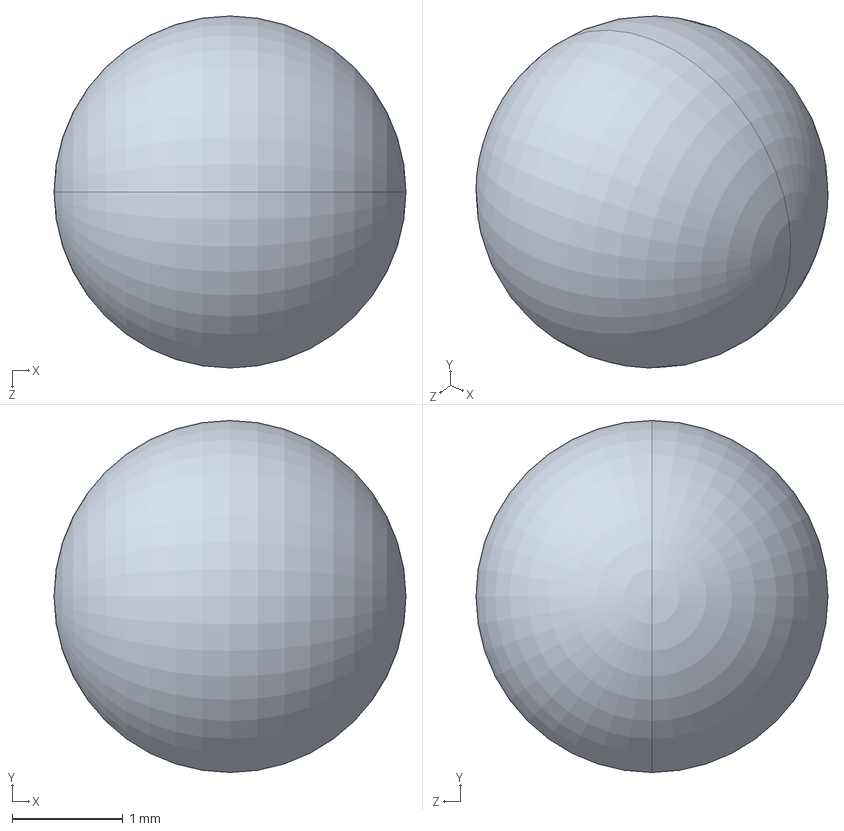
[picture p35: CAD file, 2023-05-20]
Assembly/SKF_W_619_9_2Z/SKF_W_619_9_2Z_12.sldprt
3.17 x 3.18 x 3.17 mm
