ProtiumPower/Pantograph-Robot/Assembly/Upper End Joint.SLDPRT

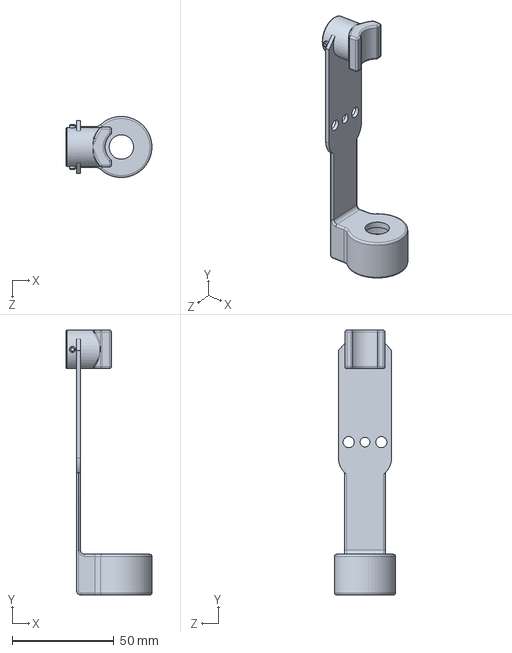
[picture p36: CAD file, 2023-05-20]
Assembly/Upper End Joint.SLDPRT
42.1 x 130.0 x 30.0 mm
