ProtiumPower/Pantograph-Robot/Assembly/60 Janatics-A51,A52 Series/Janatics-A51, A52 Series_REC-1(new).SLDPRT

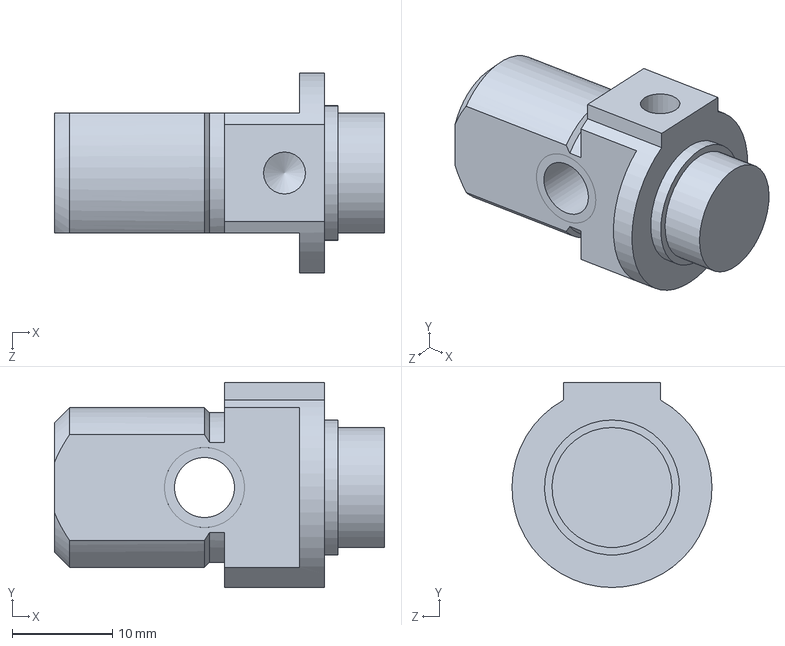
[picture p37: CAD file, 2023-05-20]
Assembly/60 Janatics-A51,A52 Series/Janatics-A51, A52 Series_REC-1(new).SLDPRT
33.0 x 20.5 x 20.0 mm
