ProtiumPower/Pantograph-Robot/Assembly/Link 1-4.SLDPRT

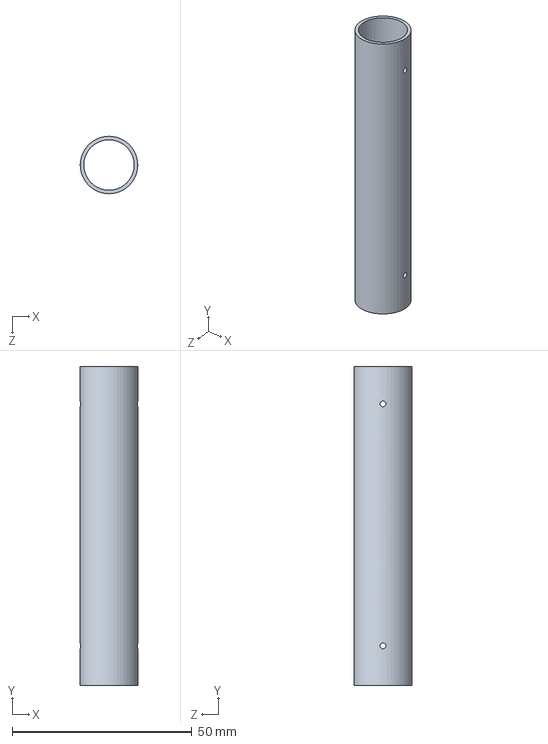
[picture p38: CAD file, 2023-05-20]
Assembly/Link 1-4.SLDPRT
16.0 x 88.7 x 16.0 mm
