ProtiumPower/Pantograph-Robot/Assembly/SKF_W_619_9_2Z/SKF_W_619_9_2Z_23.sldprt

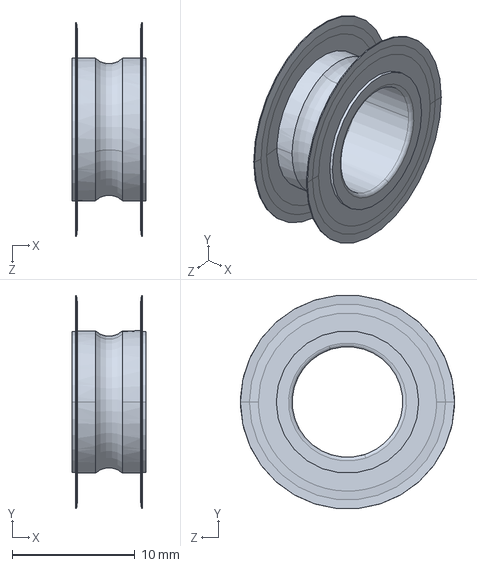
[picture p39: CAD file, 2023-05-20]
Assembly/SKF_W_619_9_2Z/SKF_W_619_9_2Z_23.sldprt
6.00 x 17.3 x 17.4 mm
