ProtiumPower/Pantograph-Robot/Assembly/Foot Bracket.SLDPRT

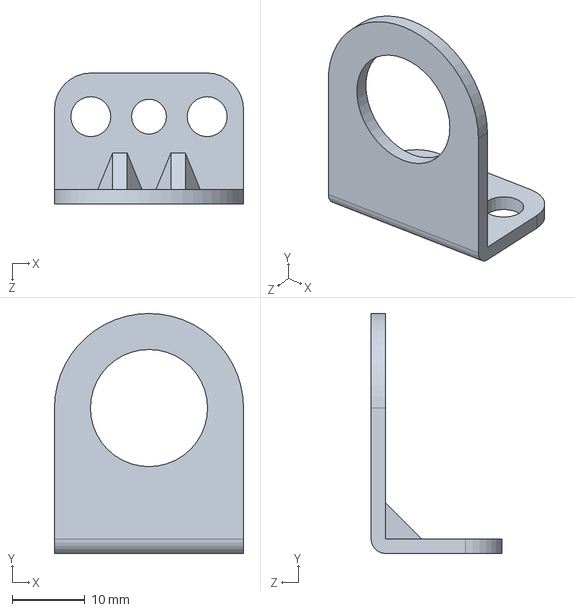
[picture p40: CAD file, 2023-05-20]
Assembly/Foot Bracket.SLDPRT
26.0 x 33.0 x 18.0 mm
