ProtiumPower/Pantograph-Robot/Assembly/SKF_W_619_9_2Z/SKF_W_619_9_2Z_21.sldprt

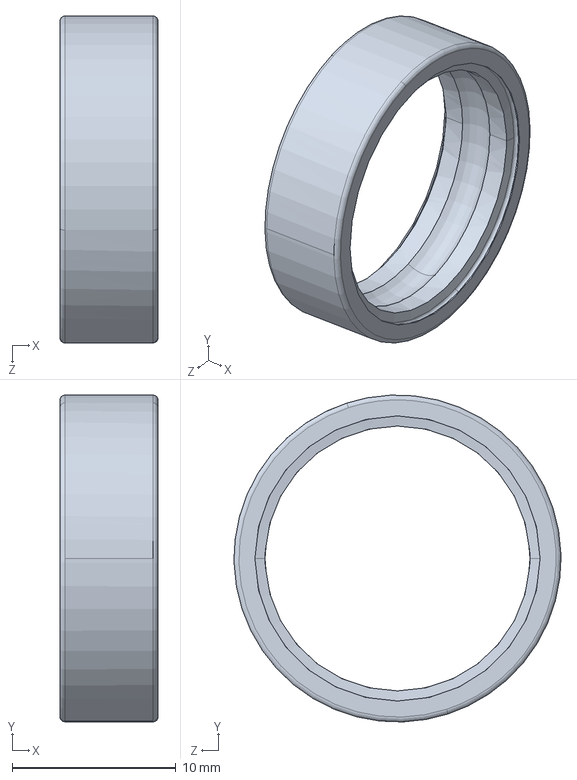
[picture p41: CAD file, 2023-05-20]
Assembly/SKF_W_619_9_2Z/SKF_W_619_9_2Z_21.sldprt
6.00 x 20.0 x 20.0 mm
