ProtiumPower/Pantograph-Robot/Assembly/60 Janatics-A51,A52 Series/Janatics-A51, A52 Series_cylinder barral (10A)(new).SLDPRT

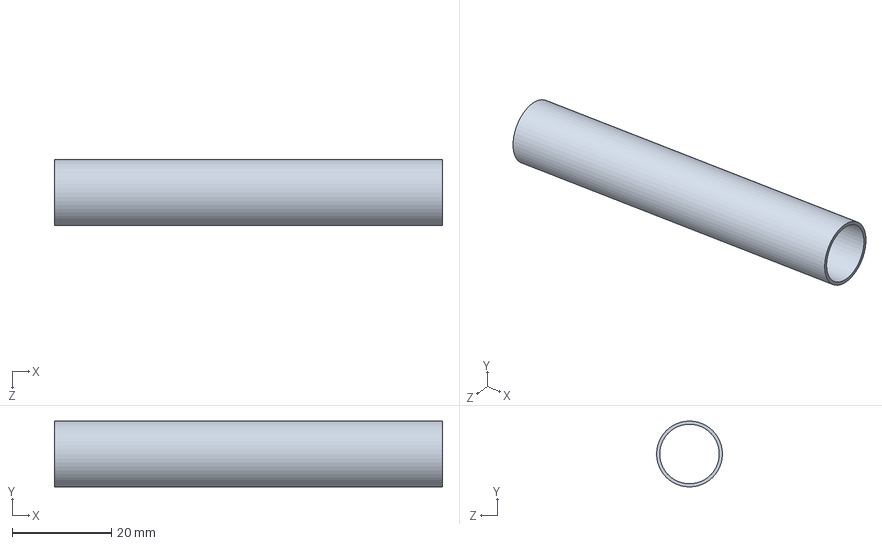
[picture p42: CAD file, 2023-05-20]
Assembly/60 Janatics-A51,A52 Series/Janatics-A51, A52 Series_cylinder barral (10A)(new).SLDPRT
78.3 x 13.3 x 13.3 mm
