ProtiumPower/Pantograph-Robot/Assembly/60 Janatics-A51,A52 Series/Janatics-A51, A52 Series_FEC(new).SLDPRT

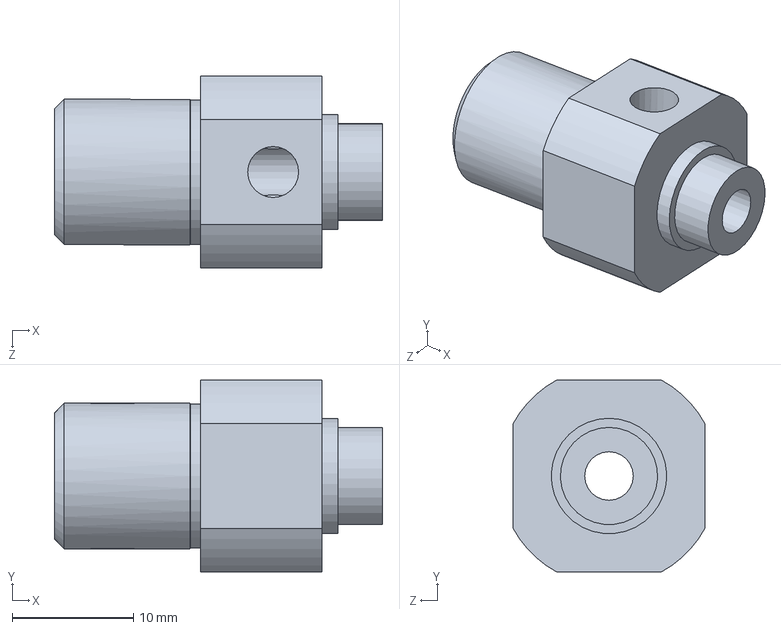
[picture p43: CAD file, 2023-05-20]
Assembly/60 Janatics-A51,A52 Series/Janatics-A51, A52 Series_FEC(new).SLDPRT
27.0 x 15.8 x 15.8 mm
