ProtiumPower/Pantograph-Robot/Assembly/DNH-20 (Retaining Ring - Housing for Part 2).SLDPRT

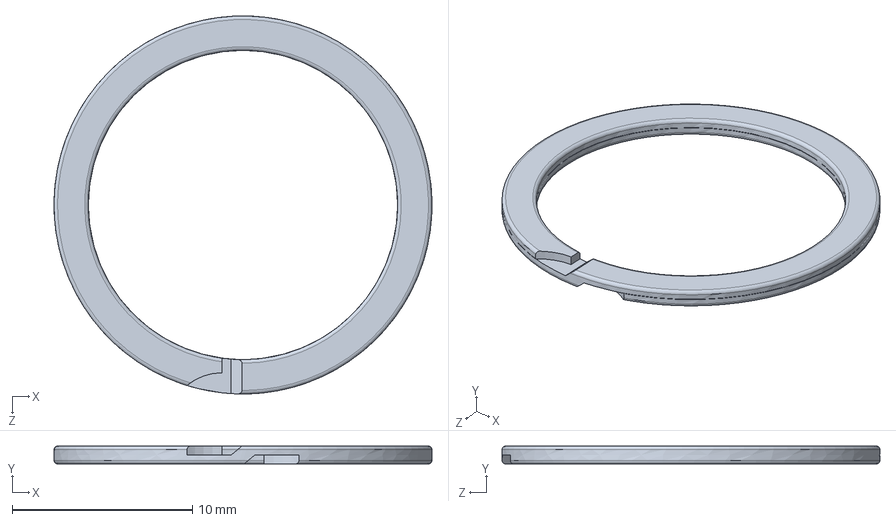
[picture p44: CAD file, 2023-05-20]
Assembly/DNH-20 (Retaining Ring - Housing for Part 2).SLDPRT
21.0 x 0.99 x 21.0 mm
