ProtiumPower/Pantograph-Robot/Assembly/Frame.SLDPRT

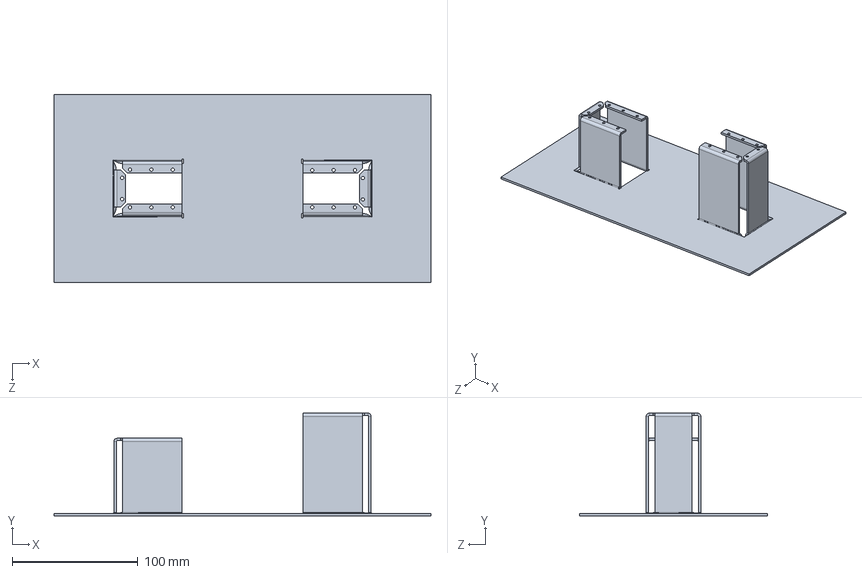
[picture p45: CAD file, 2023-05-20]
Assembly/Frame.SLDPRT
300.0 x 81.9 x 150.0 mm
