ProtiumPower/Pantograph-Robot/Assembly/Motor.SLDPRT

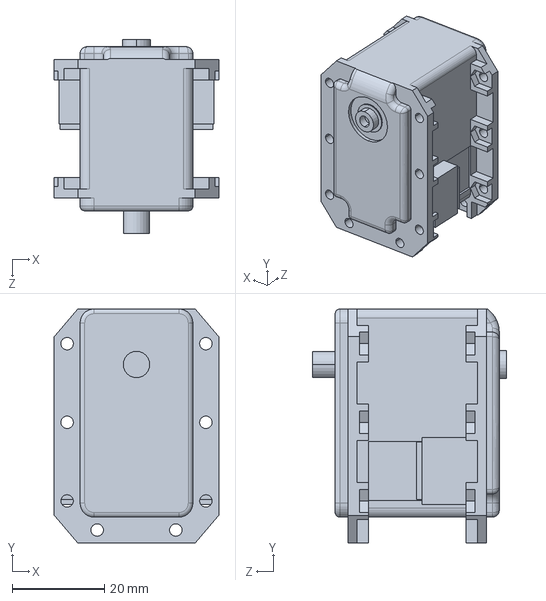
[picture p46: CAD file, 2023-05-20]
Assembly/Motor.SLDPRT
35.6 x 50.6 x 41.9 mm
