ProtiumPower/Pantograph-Robot/Assembly/Link 2-3.SLDPRT

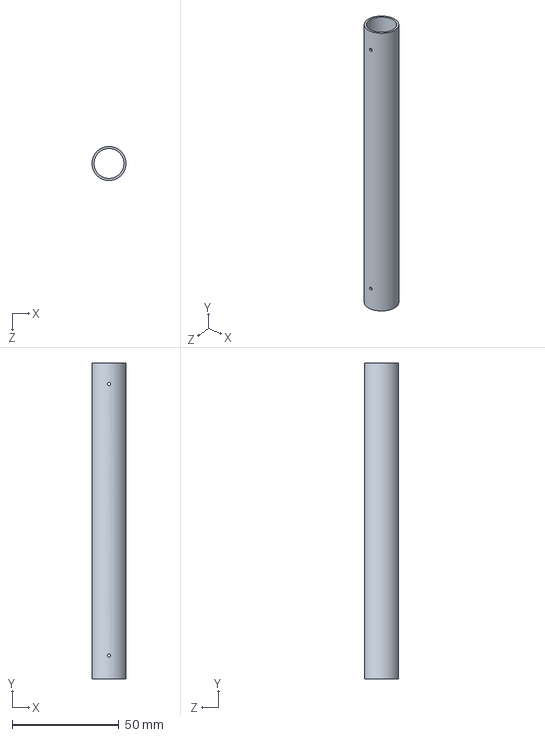
[picture p47: CAD file, 2023-05-20]
Assembly/Link 2-3.SLDPRT
16.0 x 148.1 x 16.0 mm
