ProtiumPower/Pantograph-Robot/Assembly/HN07-N101 (1).SLDPRT

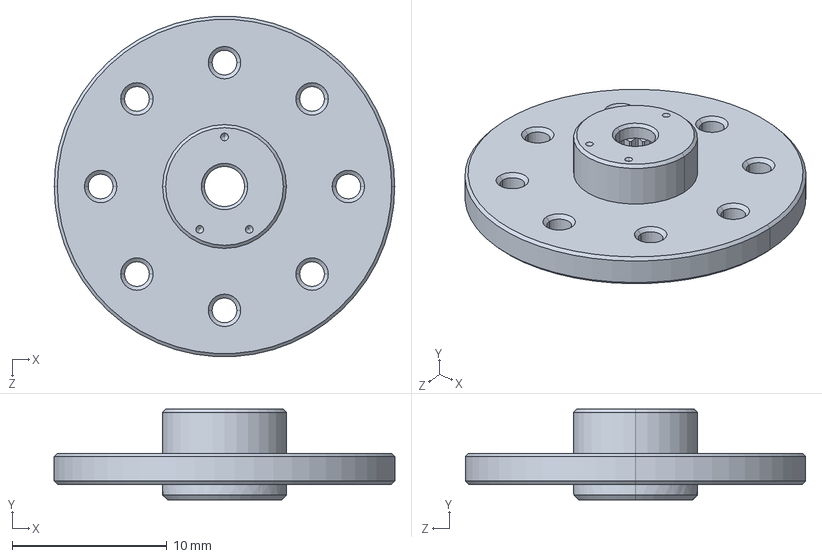
[picture p48: CAD file, 2023-05-20]
Assembly/HN07-N101 (1).SLDPRT
22.0 x 5.85 x 22.0 mm
