ProtiumPower/Pantograph-Robot/Assembly/Coupler.SLDPRT

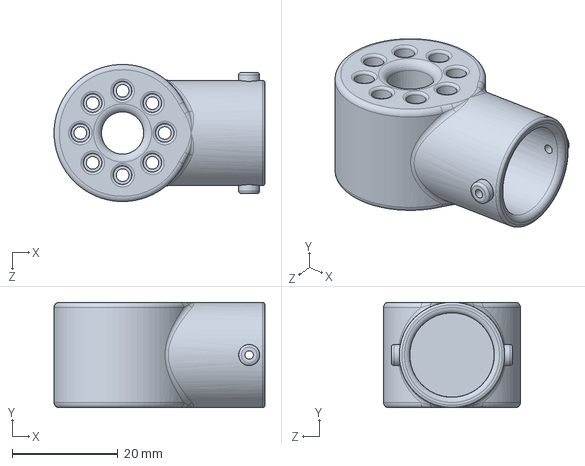
[picture p49: CAD file, 2023-05-20]
Assembly/Coupler.SLDPRT
40.0 x 20.0 x 26.0 mm
