ProtiumPower/Pantograph-Robot/Assembly/Upper Joint.SLDPRT

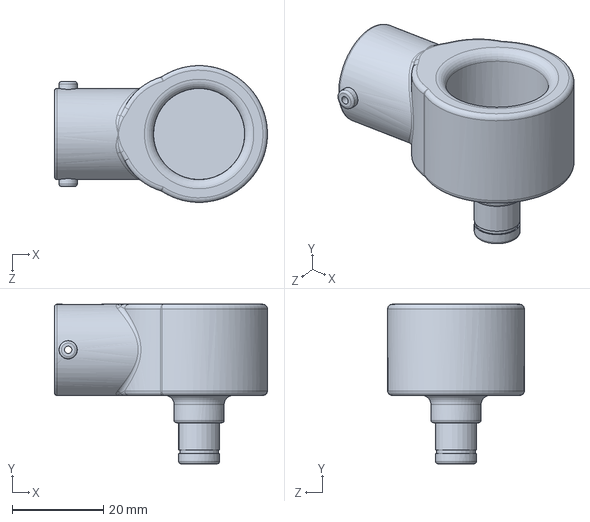
[picture p50: CAD file, 2023-05-20]
Assembly/Upper Joint.SLDPRT
46.7 x 35.0 x 30.0 mm
