ProtiumPower/Pantograph-Robot/Assembly/ES-9 (Retaining Ring - Shaft Part 2).SLDPRT

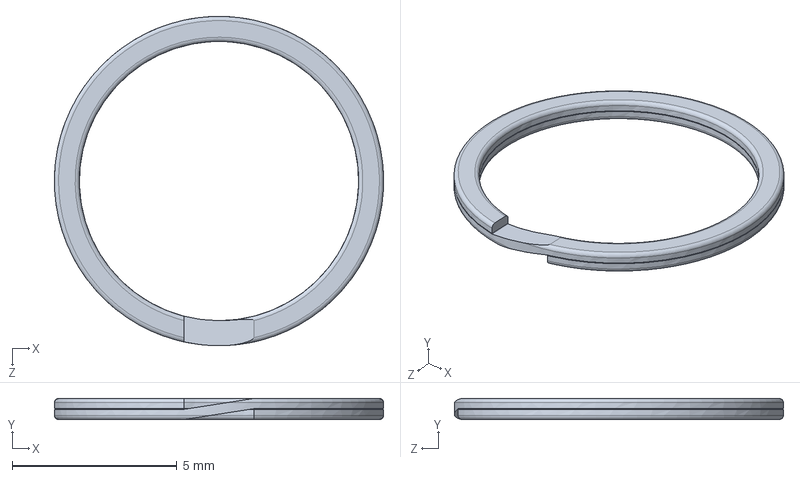
[picture p51: CAD file, 2023-05-20]
Assembly/ES-9 (Retaining Ring - Shaft Part 2).SLDPRT
10.00 x 0.64 x 9.99 mm
