ProtiumPower/Pantograph-Robot/Assembly/Lower Joint.SLDPRT

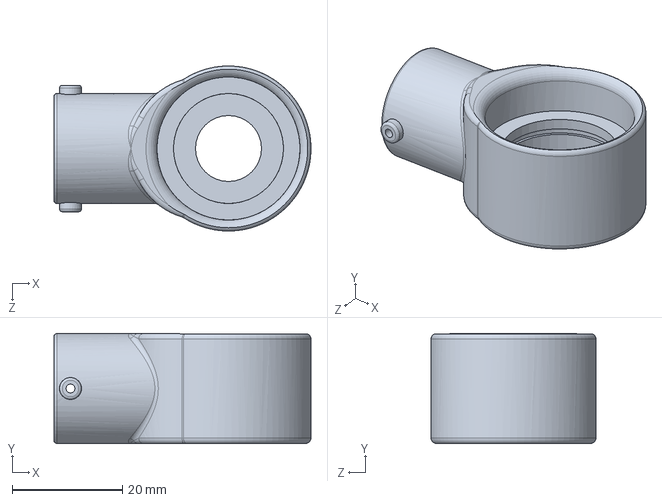
[picture p52: CAD file, 2023-05-20]
Assembly/Lower Joint.SLDPRT
46.7 x 20.0 x 30.0 mm
