ProtiumPower/Pantograph-Robot/Assembly/Electromagnet.SLDPRT

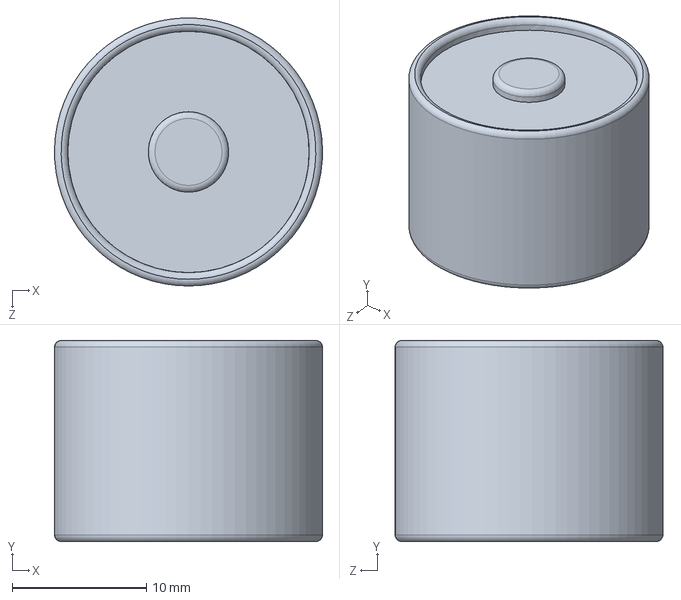
[picture p53: CAD file, 2023-05-20]
Assembly/Electromagnet.SLDPRT
20.0 x 15.0 x 20.0 mm
