ProtiumPower/Pantograph-Robot/Assembly/Lower End Joint.SLDPRT

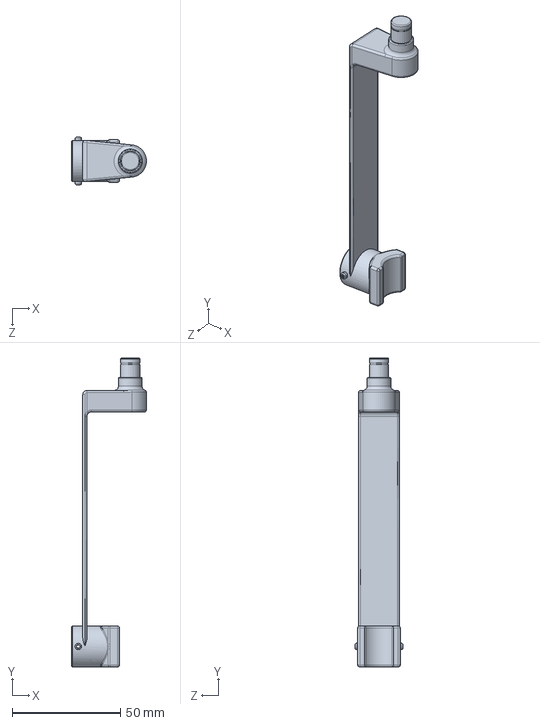
[picture p54: CAD file, 2023-05-20]
Assembly/Lower End Joint.SLDPRT
34.6 x 143.0 x 22.0 mm
