ProtiumPower/Pantograph-Robot/(list of files, cad)

Other CAD files:
Assembly/60 Janatics-A51,A52 Series/Janatics-A51, A52 Series_lock nut Dia12.SLDPRT
Assembly/60 Janatics-A51,A52 Series/Janatics-A51, A52 Series_piston rod lock nut.SLDPRT
Assembly/Nut and Bolt.SLDPRT
Assembly/THRUST_WASHER.SLDPRT
