ProtiumPower/Pantograph-Robot/Assembly/60 Janatics-A51,A52 Series/Untitled 1.pdf

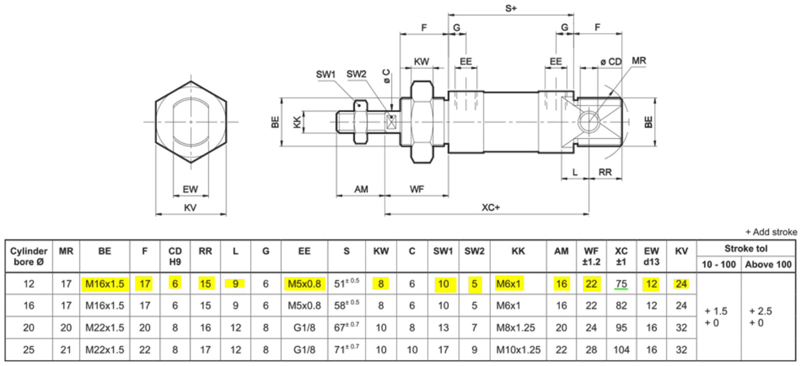
[picture p55: page 1]
